lkolbly/ledgrid/fw/src/src/README.txt

Empty application. Add your own sources.
