lkolbly/ledgrid/(threads)

Thread 1 (2020-03-26):

3.3V and GND pogo pins swapped on programming board

lkolbly, 2020-03-26:
As the title says. Also, in general, the pogo board is non-trivial to align with the board - it should probably be moved close to an edge if possible.

Thread 2 (2020-10-07):

Issues to investigate/tackle for rev C

lkolbly, 2020-10-07:
* [ ] Bring all LPC programming pins to the edge of the board (touch pads are neat but tricky in practice)
* [ ] Replace variable resistors with fixed resistors (avoid accidentally setting resistance too low, difficulties in setting exact brightness control, component cost)
* [ ] Increase linear regulator size (current part can only do absolute max = 23mA @ 12V)
* [ ] Switch to 4 layer board, add ground plane
 * [ ] If so, move mounting holes to more convenient locations
* [ ] Add pads for I2C pullups
* [ ] Add emitter-base resistor on column driver's power transistors.
* [ ] Replace IC pads with elongated pads, if possible (for easy hand-soldering. Maybe move to back side?)

And do all of the above without changing the solder mask :D
