lkolbly/ledgrid/hw-v2/column_driver.cir

[Main]
FileType=CIR
Version=12.00
Program=Micro-Cap
Component Version=10.00
Shape Version=11.00
Screen=1920,1080
MCAPVersion=12.2.0.3
Key ID=Demo
NLCnt=73
TXCnt=0

[shapedef]
Name=Bjt.root
Line=0,0,13,0
Rectangle=13,-12,15,12
Current=32,-24,32,-16
Current=32,24,32,16
Current=0,-8,8,-8
PolyOpen=3
PolyLine=24,-24
PolyLine=24,-12
PolyLine=14,-2
PolyOpen=3
PolyLine=24,24
PolyLine=24,12
PolyLine=14,2

[shapedef]
Name=Diode
Root="Diode.root",0,0,0

[shapedef]
Name=Diode.root
Line=0,0,20,0
Line=28,0,48,0
Rectangle=18,-8,20,8
PolyClosed=3
PolyLine=20,0
PolyLine=28,-8
PolyLine=28,8
Current=32,16,16,16

[shapedef]
Name=Ground
Line=0,0,12,0
Line=12,-8,12,8
Line=18,-4,18,4
Line=24,0,24,0

[shapedef]
Name=Inv
Root="Inv.root",0,0,0

[shapedef]
Name=Inv.root
Line=8,-16,8,16
Line=8,-16,40,0
Line=8,16,40,0
Line=0,0,8,0
Ellipse=40,-2,44,2
FColor=None
Line=44,0,47,0
Line=46,0,48,0

[shapedef]
Name=Isource.Root
Ellipse=-12,12,12,36
FColor=None
Line=0,0,0,24
PolyClosed=3
PolyLine=-4,24
PolyLine=4,24
PolyLine=0,32
Line=0,32,0,48
Current=16,16,16,32

[shapedef]
Name=NPN
Root="Bjt.root",0,0,0
PolyClosed=3
PolyLine=20,12
PolyLine=24,12
PolyLine=24,8

[shapedef]
Name=Plus.root
Line=-2,0,2,0
Line=0,-2,0,2

[shapedef]
Name=PNP
Root="Bjt.root",0,0,0
PolyClosed=3
PolyLine=17,-5
PolyLine=21,-5
PolyLine=17,-9
Line=16,-4,14,-2
Line=16,4,14,2

[shapedef]
Name=Resistor
PolyOpen=12
PolyLine=0,0
PolyLine=0,0
PolyLine=12,0
PolyLine=14,-4
PolyLine=18,4
PolyLine=22,-4
PolyLine=26,4
PolyLine=30,-4
PolyLine=34,4
PolyLine=36,0
PolyLine=48,0
PolyLine=48,0
Current=32,8,16,8

[shapedef]
Name=SPICE_I
Root="Isource.Root",0,0,0

[shapedef]
Name=SPICE_V
Root="Vsource.root",0,0,0

[shapedef]
Name=StimClock
Arc=50,-8,62,8 , 56,8,62,0
Arc=50,-8,62,8 , 62,0,56,-8
Line=13,8,57,8
Arc=8,-8,18,8 , 13,-8,8,0
Ellipse=53,-3,59,3
Line=64,0,72,0
Arc=8,-8,18,8 , 8,0,13,8
Line=13,-8,57,-8
Line=56,0,64,0
Line=16,4,20,4
Line=20,4,20,-4
Line=20,-4,24,-4
Line=24,-4,24,4
Line=24,4,28,4
Line=28,4,28,-4
Line=28,-4,32,-4
Line=32,-4,32,4
Line=32,4,36,4
Line=36,4,36,-4
Line=36,-4,40,-4
Line=40,-4,40,4
Line=40,4,44,4
Line=44,4,44,-4
Line=44,-4,48,-4
Line=48,-4,48,4
Line=48,4,52,4

[shapedef]
Name=Vsource.root
Line=0,0,12,0
Line=36,0,48,0
Ellipse=12,-12,36,12
FColor=None
Line=7,5,7,9
Root="Plus.root",41,7,0
Current=32,16,16,16

[compdef]
Name=Resistor
Definition=Resistor
Shape=Resistor
Mask=6913
Used=154
memo=Resistor
Label Offset=18,6,8,11
PinCnt=2
Pin="Plus",6,0,-10,-4
Pin="Minus",0,0,-14,-4

[compdef]
Name=PNP
Definition=PNP
Shape=PNP
Mask=4609
Used=4
memo=PNP Transistor
Label Offset=37,-13,-8,35
PinCnt=3
Pin="Collector",3,3,6,3
Pin="Base",0,0,-19,-3
Pin="Emitter",3,-3,6,15

[compdef]
Name=NPN
Definition=NPN
Shape=NPN
Mask=5633
Used=15
memo=NPN Transistor
Label Offset=37,-17,-14,33
PinCnt=3
Pin="Collector",3,-3,4,14
Pin="Base",0,0,-18,-3
Pin="Emitter",3,3,5,1

[compdef]
Name=Ground
Definition=Ground
Shape=Ground
Mask=1793
Used=261
memo=Ground
Label Offset=0,0,0,0
PinCnt=1
Pin="PinA",0,0,-3,-7

[compdef]
Name=Voltage Source
Definition=VSpice
Shape=SPICE_V
Mask=5377
Used=41
memo=Voltage Source
Label Offset=19,13,15,13
PinCnt=2
Pin="Plus",6,0,-5,-6
Pin="Minus",0,0,-20,-6

[compdef]
Name=DClock
Definition=Macro
Shape=StimClock
Mask=5376
Used=3
memo=Digital Clock Stimulus Macro
Link=http://www.spectrum-soft.com/news/fall2003/dclock.shtm
Label Offset=29,10,12,21
PinCnt=1
Pin="Out",d,9,0

[compdef]
Name=D-LED
Definition=Subckt
Shape=Diode
Mask=6272
Used=6
memo=On Semi
Label Offset=0,0,0,0
PinCnt=2
Pin="1",a,6,0,1,0
Pin="2",a,0,0

[compdef]
Name=Current Source
Definition=ISpice
Shape=SPICE_I
Mask=6401
Used=7
memo=Current Source
Label Offset=15,12,-29,12
PinCnt=2
Pin="Plus",0,0,8,11
Pin="Minus",0,6,8,3

[compdef]
Name=Inverter
Definition=INV
Shape=Inv
Mask=4611
Used=1
Data1=1
memo=Generic Inverter Gate
Label Offset=12,-6,11,21
PinCnt=2
Pin="In",0,0,-4,-2
Pin="Out",6,0,-10,-2

[Circuit]
Window Placement=2,3, -1,-1, -8,-31, 104,104,1559,680
Default Object=Color=#000080
Default Object Font=Height=-15,FStyle=0,Color=#000080,Name=Arial
Default Object Apply Border To Text=No
Default Object Apply Fill To Text=No
Default Object GridSnap=No
NodeVoltageFormat=3
CurrentFormat=3
PowerFormat=3
PathDelayFormat=3
WarningFormat=3
GridTextFormulaFormat=3
Window Placement in Transient Analysis=2,3, -1,-1, -8,-31, 260,260,1911,836
Window Placement in DC Analysis=2,3, -1,-1, -8,-31, 130,130,1781,706
Window Placement in DC Probe=0,1, -1,-1, -8,-31, 953,0,1906,832
SpiceType=AMBIGUOUS
Title_Block_Border=None
Title_Block=False
Show Nodes=False
Show Voltages=False
Show Current=False
Show Power=False
Show Condition=False
Show Pin Connections=False
Show Connection Warnings=False
Show Cross=False
Show Attribute Text=True
Show Grid Text=True

[Comp]
Name=Resistor
Px=632,392
Rot=3

[Attr]
ON=-24,-25,PART
V=R1
Style=8192

[Attr]
ON=-24,-39,RESISTANCE
V=1K
Style=8192

[Attr]
ON=0,0,PACKAGE
V

[Comp]
Name=Resistor
Px=696,488
Rot=3

[Attr]
ON=-24,-25,PART
V=R2
Style=8192

[Attr]
ON=-24,-39,RESISTANCE
V=1K
Style=8192

[Attr]
ON=0,0,PACKAGE
V

[Comp]
Name=PNP
Px=632,312
Rot=5

[Attr]
ON=-10,-43,PART
V=Q1
Style=8192

[Attr]
ON=-104,-15,MODEL
V=MMST3906

[Attr]
ON=-75,-43,PACKAGE
V=SC-59

[Comp]
Name=NPN
Px=696,440
Rot=3

[Attr]
ON=-7,-43,PART
V=Q2
Style=8192

[Attr]
ON=-86,-3,MODEL
V=BC850B

[Attr]
ON=-82,25,PACKAGE
V=SOT-23

[Comp]
Name=Ground
Px=720,416
Rot=7

[Wire]
Pxs=632,392,632,416

[Wire]
Pxs=632,416,672,416

[Wire]
Pxs=632,312,632,344

[Comp]
Name=Voltage Source
Px=728,360
Rot=5

[Attr]
ON=15,-27,PART
V=V1
Style=8192

[Attr]
ON=15,-41,VALUE
V=DC 12 AC 0 0 

[Attr]
ON=0,0,PACKAGE
V

[Attr]
ON=0,0,SMOOTHING
V=N
Style=256

[Attr]
ON=0,0,Saved_PulseS
V=N
Style=256

[Attr]
ON=0,0,FRACTION
V=.2
Style=256

[Attr]
ON=0,0,Saved_PulseF
V=.2
Style=256

[Attr]
ON=0,0,Saved_Pulse
V=DC 0 AC 1 0 Pulse 0 5 100n 10n 10n 400n 1u
Style=256

[Attr]
ON=0,0,Saved_None
V=DC 12 AC 0 0 
Style=256

[Wire]
Pxs=728,360,728,416

[Wire]
Pxs=720,416,728,416

[Wire]
Pxs=728,288,728,312

[Wire]
Pxs=656,288,728,288

[Comp]
Name=DClock
Px=816,624
Rot=5

[Attr]
ON=12,-35,PART
V=X1
Style=8192

[Attr]
ON=12,-49,FILE
V=DClock

[Attr]
ON=12,-77,Param:ZEROWIDTH
V=4us

[Attr]
ON=12,-91,Param:ONEWIDTH
V=4us

[Attr]
ON=0,0,PACKAGE
V

[Comp]
Name=D-LED
Px=472,224

[Attr]
ON=0,0,PART
V=X2
Style=8192

[Attr]
ON=0,14,NAME
V=D-LED
Style=8192

[Attr]
ON=0,0,PACKAGE
V

[Comp]
Name=D-LED
Px=472,280

[Attr]
ON=0,0,PART
V=X3
Style=8192

[Attr]
ON=0,14,NAME
V=D-LED
Style=8192

[Attr]
ON=0,0,PACKAGE
V

[Comp]
Name=D-LED
Px=472,336

[Attr]
ON=0,0,PART
V=X4
Style=8192

[Attr]
ON=0,14,NAME
V=D-LED
Style=8192

[Attr]
ON=0,0,PACKAGE
V

[Wire]
Pxs=520,224,568,224

[Wire]
Pxs=568,224,568,280

[Wire]
Pxs=520,336,568,336

[Wire]
Pxs=520,280,568,280

[Wire]
Pxs=568,280,568,288

[Wire]
Pxs=568,288,608,288

[Wire]
Pxs=568,288,568,336

[Comp]
Name=Current Source
Px=416,224
Rot=1

[Attr]
ON=-29,12,PART
V=I1
Style=8192

[Attr]
ON=-29,26,VALUE
V=DC 0.03 AC 0 0 
Style=8192

[Attr]
ON=0,0,PACKAGE
V

[Attr]
ON=0,0,SMOOTHING
V=N
Style=256

[Attr]
ON=0,0,Saved_PulseS
V=N
Style=256

[Attr]
ON=0,0,FRACTION
V=.2
Style=256

[Attr]
ON=0,0,Saved_PulseF
V=.2
Style=256

[Attr]
ON=0,0,Saved_Pulse
V=DC 0 AC 1 0 Pulse 0 5 100n 10n 10n 400n 1u
Style=256

[Attr]
ON=0,0,Saved_None
V=DC 0.03 AC 0 0 
Style=256

[Comp]
Name=Current Source
Px=416,280
Rot=1

[Attr]
ON=-29,12,PART
V=I2
Style=8192

[Attr]
ON=-29,26,VALUE
V=DC 0.03 AC 0 0 
Style=8192

[Attr]
ON=0,0,PACKAGE
V

[Attr]
ON=0,0,Saved_None
V=DC 0.03 AC 0 0 
Style=256

[Comp]
Name=Current Source
Px=416,336
Rot=1

[Attr]
ON=-29,12,PART
V=I3
Style=8192

[Attr]
ON=-29,26,VALUE
V=DC 0.03 AC 0 0
Style=8192

[Attr]
ON=0,0,PACKAGE
V

[Comp]
Name=Ground
Px=344,376
Rot=7

[Wire]
Pxs=344,224,368,224

[Wire]
Pxs=344,224,344,280

[Wire]
Pxs=344,280,368,280

[Wire]
Pxs=344,280,344,336

[Wire]
Pxs=344,336,368,336

[Wire]
Pxs=344,336,344,376

[Comp]
Name=Resistor
Px=864,336
Rot=3

[Attr]
ON=-24,-25,PART
V=R3
Style=8192

[Attr]
ON=-24,-39,RESISTANCE
V=1K
Style=8192

[Attr]
ON=0,0,PACKAGE
V

[Comp]
Name=Resistor
Px=928,432
Rot=3

[Attr]
ON=-24,-25,PART
V=R4
Style=8192

[Attr]
ON=-24,-39,RESISTANCE
V=1K
Style=8192

[Attr]
ON=0,0,PACKAGE
V

[Comp]
Name=PNP
Px=864,256
Rot=5

[Attr]
ON=-10,-43,PART
V=Q3
Style=8192

[Attr]
ON=-104,-15,MODEL
V=MMST3906

[Attr]
ON=-75,-43,PACKAGE
V=SC-59

[Comp]
Name=NPN
Px=928,384
Rot=3

[Attr]
ON=-7,-43,PART
V=Q4
Style=8192

[Attr]
ON=-86,-3,MODEL
V=BC850B

[Attr]
ON=-82,25,PACKAGE
V=SOT-23

[Comp]
Name=Ground
Px=952,360
Rot=7

[Wire]
Pxs=864,336,864,360

[Wire]
Pxs=864,360,904,360

[Wire]
Pxs=864,256,864,288

[Comp]
Name=Voltage Source
Px=960,304
Rot=5

[Attr]
ON=15,-27,PART
V=V2
Style=8192

[Attr]
ON=15,-41,VALUE
V=DC 12 AC 0 0 

[Attr]
ON=0,0,PACKAGE
V

[Attr]
ON=0,0,SMOOTHING
V=N
Style=256

[Attr]
ON=0,0,Saved_PulseS
V=N
Style=256

[Attr]
ON=0,0,FRACTION
V=.2
Style=256

[Attr]
ON=0,0,Saved_PulseF
V=.2
Style=256

[Attr]
ON=0,0,Saved_Pulse
V=DC 0 AC 1 0 Pulse 0 5 100n 10n 10n 400n 1u
Style=256

[Attr]
ON=0,0,Saved_None
V=DC 12 AC 0 0 
Style=256

[Wire]
Pxs=960,304,960,360

[Wire]
Pxs=952,360,960,360

[Wire]
Pxs=960,232,960,256

[Wire]
Pxs=888,232,960,232

[Comp]
Name=Inverter
Px=816,552
Rot=5

[Attr]
ON=-29,-8,PART
V=U1
Style=8192

[Attr]
ON=-68,-22,TIMING MODEL
V=D0_GATE

[Attr]
ON=-59,-36,I/O MODEL
V=IO_STD

[Attr]
ON=-20,-50,MNTYMXDLY
V=0

[Attr]
ON=-20,-64,IO_LEVEL
V=0

[Attr]
ON=-76,-78,POWER NODE
V=$G_DPWR

[Attr]
ON=-73,-92,GROUND NODE
V=$G_DGND

[Attr]
ON=0,0,PACKAGE
V

[Wire]
Pxs=696,504,816,504

[Wire]
Pxs=696,488,696,504

[Wire]
Pxs=816,552,928,552

[Wire]
Pxs=928,432,928,552

[Comp]
Name=D-LED
Px=472,48

[Attr]
ON=0,0,PART
V=X5
Style=8192

[Attr]
ON=0,14,NAME
V=D-LED
Style=8192

[Attr]
ON=0,0,PACKAGE
V

[Comp]
Name=D-LED
Px=472,104

[Attr]
ON=0,0,PART
V=X6
Style=8192

[Attr]
ON=0,14,NAME
V=D-LED
Style=8192

[Attr]
ON=0,0,PACKAGE
V

[Comp]
Name=D-LED
Px=472,160

[Attr]
ON=0,0,PART
V=X7
Style=8192

[Attr]
ON=0,14,NAME
V=D-LED
Style=8192

[Attr]
ON=0,0,PACKAGE
V

[Wire]
Pxs=520,48,568,48

[Wire]
Pxs=520,160,568,160

[Wire]
Pxs=520,104,568,104

[Wire]
Pxs=416,48,472,48

[Wire]
Pxs=416,48,416,224

[Wire]
Pxs=432,104,472,104

[Wire]
Pxs=432,104,432,280

[Wire]
Pxs=448,160,472,160

[Wire]
Pxs=448,160,448,336

[Wire]
Pxs=416,336,448,336

[Wire]
Pxs=448,336,472,336

[Wire]
Pxs=416,280,432,280

[Wire]
Pxs=432,280,472,280

[Wire]
Pxs=416,224,472,224

[Wire]
Pxs=568,48,568,104

[Wire]
Pxs=568,104,568,160

[Wire]
Pxs=568,104,840,104

[Wire]
Pxs=840,104,840,232

[Schematic]
CurrentSection 0=0
CurrentSection 1=0
CurrentSection 2=0
CurrentSection 3=0
Splitter.xs=0
Splitter.ys=0
TextQuad=4099
Scale=1
GridUser=10
ShapeGroups="Main","Euro","Polarity","Main1","Main11","Electrolytic","GroundArrow","DeMorgan"
CalcRMS=False
CalcAVG=False
CalcPeak=False
CalcVoltage=True
DisplayMeasure=Last
ShareScales=True

[Tools]
Pos=Top
FILESAVEASOLD=No
BOM=No
FILEPCB=No
PROBE=Yes
SELECT=Yes
PAN=Yes
COMP=Yes
TEXT=Yes
WIRE=Yes
WIRED=Yes
BUS=Yes
GRAPHIC=Yes
FLOWCHART=Yes
LINE=No
ELLIPSE=No
RECT=No
DIAM=No
ARC=No
PIE=No
TRIANGLE=No
STAR=No
LEFTBRK=No
RIGHTBRK=No
BOTHBRK=No
META=Yes
PARALLELOGRAM=No
FC_PROCESS=No
FC_ALT_PROCESS=No
FC_DECISION=No
FC_DATA=No
FC_PREDEFPROCESS=No
FC_INTERNALSTORAGE=No
FC_DOCUMENT=No
FC_MULTIDOCUMENT=No
FC_TERMINATOR=No
FC_PREPARATION=No
FC_MANUALINPUT=No
FC_MANUALOPERATION=No
FC_CONNECTOR=No
FC_OFFPAGECONNECTOR=No
FC_PUNCHCARD=No
FC_PUNCHEDTAPE=No
FC_SUMMING_JUNCTION=No
FC_OR=No
FC_COLLATE=No
FC_SORT=No
FC_EXTRACT=No
FC_MERGE=No
FC_STORED_DATA=No
FC_DELAY=No
FC_SAS=No
FC_MAGNETIC_DISK=No
FC_DAS=No
FC_DISPLAY=No
SPREAD_SHEET=Yes
POLYCLOS=No
POLYOPEN=No
FLAG=Yes
INFO=Yes
HELP=Yes
HELP_SPICE=No
LINK=Yes
CHECK=Yes
REGION_ENABLE=Yes
TITLE_BLOCK=Yes
DIGTRC=No
DIGTRC2=No
BUILD_COMMAND=Yes
DIGALL=No
GRIDTEXT=Yes
COMPTEXT=Yes
NODE=Yes
MEASURED=Yes
NODEV=Yes
CURRENT=Yes
POWER=Yes
CONDITIN=Yes
PIN=Yes
CONNWARN=Yes
CROSS=Yes
GRID=Yes
BORDER=Yes
BORDERONE=Yes
TITLE=Yes
RUBBER=Yes
PROPERTY=Yes
STEP=Yes
MIRROR=Yes
ROTATE=Yes
FLIPY=Yes
FLIPX=Yes
CIR_MAKEMACRO=No
CLEARCUTWIRE=No
CLIPBOARDCIRPAGE2BMM=No
FINDCOMP=Yes
FIND=Yes
REPEAT=No
REPLACE=No
MODEL=Yes
CIR2CKT=Yes
ATTDISP=Yes
ENABLE=Yes
DISABLE=Yes
ENABLE_WITH=Yes
TOFRONT=Yes
TOBACK=Yes
SELNEXT=Yes
PAGEADD=Yes
PAGEADDTEXT=No
ADDSECTION=No
PAGEDEL=Yes
ZOOMIN=Yes
ZOOMOUT=Yes
AUTOSCALECIR=Yes
GOTOFLAG=Yes
UPLEVEL=Yes
COLOR=Yes
FONT=Yes
STYLE=Yes
DM_LAST=No
DM_RMS=No
DM_AVG=No
DM_PEAK=No
GRID_NONE=No
GRID_NORMAL=No
GRID_BOLD_5=No
GRID_BOLD_6=No
GRID_BOLD_USER=No
GRAPH_PAPER=No
SPLITCIRTEXTH=No
SPLITCIRTEXTV=No
SPACE_SPLITTERS_EVENLY=No
NORMALCIR=No
RENAMEDEFINE=No
RENAMECMP=No
ATTALIGN=No
RESETNODEPOS=No
FIT2STANDARD=No
NODESNAP=No
MOVETEXT=No
TEXTINC=No
TOGGLETEXT=No
TOGGLEMODE=No
TOLERANCE=No
ALIGNAB=No
ALIGNLEFT=Yes
ALIGNCENTER=Yes
ALIGNRIGHT=Yes
ALIGNTOP=Yes
ALIGNMIDDLES=Yes
ALIGNBOTTOM=Yes

[Section]
Index=0
Name="column_driver"
Type=Main
Enable=True
CurrentPage 0=0
CurrentPage 1=0
CurrentPage 2=0
CurrentPage 3=0
TabSize 0=425
TabSize 1=425
TabSize 2=425
TabSize 3=425

[Page]
Index=0
Section=0
Print=True
Enable=True
Name=Main
PrinterScale=1
Scale 0=1
Scale 1=1
Scale 2=1
Scale 3=1
Px=814,586
WinBackGround Color=#FFFFFF
Select Color=#FF0000
Anchor Color=#000000
Select Box Color=#000080
Grid Text Color=Height=-12,FStyle=0,Color=#0000FF,Name=Verdana
Grid Text RTF=False
Grid Text Angle=0
Grid Text GridSnap=True
Grid Text PinIt=False
Grid Text JustifyH=Left
Grid Text JustifyV=Bottom
Grid GradientColor2=None
Grid OutlineThickness=1
Grid OutlineColor=None
Component Color=#0000FF
Attribute Text=Height=-12,FStyle=0,Color=#008000,Name=Verdana
Wire Color=#008000
Bus Color=#008000
Pin Connection=Height=-10,FStyle=0,Color=#FF0000,Name=Arial
Pin Marker Color=#008000
Node Number=Height=-11,FStyle=0,Color=#FF00FF,Name=Arial
Node Voltage Color=Height=-11,FStyle=0,Color=#000000,Name=Arial
Dynamic AC Voltage Color=#E4E4E4
Text Banner Text=Height=-15,FStyle=0,Color=#800000,Name=Arial
Title Block Background=#C0C0C0
Current=Height=-11,FStyle=0,Color=#0000FF,Name=Arial
Power/Condition=Height=-11,FStyle=0,Color=#FF0000,Name=Arial
Digital Path Color=#FF0000
Title Block Border=#000000
Disabled	Color=#C0C0C0
Search Color=#FFFF00
Grid Color=#000000
Graph Paper=#E4E4E4
Digital 0 Color=#000000
Digital R Color=#FFFF00
Digital F Color=#FFFF00
Digital 1 Color=#FF0000
Digital X Color=#C0C0C0
Digital Z Color=#808080
Block Select Color=#51F998

[Page]
Index=1
Section=0
Type=Text
Print=False
Enable=True
Name=Text
Font=Height=-15,FStyle=0,Color=#000000,Name=Courier New
Comment Color=#008000
WinBackGround Color=#FFFFFF
Disabled	Color=#C0C0C0
KeyWord Color=#0000FF
Error	Color=#FF0000
Search Color=#FFFF00

[Page]
Index=2
Section=0
Type=Text
Print=False
Enable=True
Name=Models
SB 0=0,31
Font=Height=-15,FStyle=0,Color=#000000,Name=Courier New
Comment Color=#008000
WinBackGround Color=#FFFFFF
Disabled	Color=#C0C0C0
KeyWord Color=#0000FF
Error	Color=#FF0000
Search Color=#FFFF00

[Page]
Index=3
Section=0
Type=Info
Print=False
Enable=True
Name=Info
Font=Height=-15,FStyle=0,Color=#000000,Name=Courier New
Comment Color=#008000
WinBackGround Color=#FFFFFF
Disabled	Color=#C0C0C0
KeyWord Color=#0000FF
Error	Color=#FF0000
Search Color=#FFFF00

[Text Area]
Section=0
Page=1
Text=.OPTIONS ITL4=50

[Text Area]
Section=0
Page=2
Text=* Schematic File
Text=*
Text=* Syntax:
Text=* .MODEL <model name> [AKO:<reference model name>] <ModelType>
Text=* +([<parameter name>=<value>][LOT[/#][/GAUSS|/UNIFORM|/WCASE]=[<tol>[%]] |[-<low>%,<high>%]][DEV[/#][/GAUSS|/UNIFORM|/WCASE]=[<tol>[%]]...)
Text=* ModelType must be one of OPA,D,NPN,NMOS,NJF,PUL,SIN,TRN,CORE,GASFET,VSWITCH,ISWITCH,CAP,IND,RES,PNP,PMOS,PJF,DOUTPUT,DINPUT,UADC,UDAC,UGATE,UTGATE,UEFF,UGFF,UDLY,UPLD,UROM,URAM,UBGT,UIO,LPNP,NIGBT,I,V
Text=*
Text=*Examples:
Text=* .MODEL 2N2222A NPN(BF=150 IS=1E-14)
Text=* .model M1 NMOS(KP=2.5E-5 VTO=1.345 CGDO=14.67p CGBO=4.566p)
Text=* .MODEL DK D(IS=1E-18)
Text=* .model 2N2222A AKO:2N2222 NPN (BF=55 ISE=10F)
Text=* .Model BJT1 NPN (RE=12 LOT/1/GAUSS=30% DEV/2/UNIFORM=2%)
Text=*
Text=* A .cir file is typically found in the data directory
Text=*
Text=*** From file C:\MC12\library\DIODESINC_BJT.LIB
Text=.MODEL MMSTA55 PNP (BF=331 BR=4.00 CJC=40.2P CJE=125P EG=1.12 IKF=0.182
Text=+ IKR=0.450 IS=50.2F ISE=20.3P MJC=0.300 MJE=0.500 NE=2.00 NF=1.00 NR=1.00
Text=+ RB=0.532 RC=53.2M RE=0.133 TF=2.16N TR=350N VAF=139 VAR=16.0 VJC=0.300
Text=+ VJE=1.10 XTB=1.5)
Text=*** From file C:\MC12\library\ROHM_TRANSISTOR.LIB
Text=.MODEL MMSTA56 PNP (BF=235.45 BR=6.9168 CJC=36.541E-12 CJE=132.70E-12
Text=+ IKF=1.6011 IKR=.94462 IS=300.00E-15 ISC=6.2373E-12 ISE=300.00E-15 ITF=29.965
Text=+ MJC=.44608 MJE=.4689 NC=1.4308 NE=1.5074 NK=.82728 RB=.91923 RC=.13026 RE=.15
Text=+ TF=681.79E-12 TR=144.75E-9 VAF=39.033 VAR=100 VJC=.74006 VJE=.99813
Text=+ VTF=119.68 XTB=1.5000 XTF=78.625)
Text=*** From file C:\MC12\library\DIODESINC_BJT.LIB
Text=.MODEL MMSTA92 PNP (BF=164 BR=4.00 CJC=16.8P CJE=52.0P EG=1.12 IKF=66.8M
Text=+ IKR=0.165 IS=53.7F ISE=25.7P MJC=0.300 MJE=0.500 NE=2.00 NF=1.00 NR=1.00
Text=+ RB=2.26 RC=0.226 RE=0.565 TF=2.46N TR=426N VAF=312 VAR=20.0 VJC=0.300
Text=+ VJE=1.10 XTB=1.5)

[InfoPage]
InfoPage=True
Warnings=True
System=True
Defines=True
Array=True
Model=True
Measure=True
MacroSubckt=True
NotUsed=True
ComponentCounts=True
VariablizePaths=False
DontShowPaths=False
SimulationLog=True

[Transient]
WinID=1
Window Placement=2,3, -1,-1, -8,-31, 260,260,1911,836
Font=Height=-19,FStyle=0,Color=#0000FF,Name=Arial
WinBackGround Color=#FFFFFF
Select Color=#FF0000
Anchor Color=#000000
Select Box Color=#000080
Title=column_driver.cir
AutoTitle=Yes
Grid Color=#808080
Grid Weight=1
Grid Pattern=Dot6
Tracker Foreground=Height=-15,FStyle=0,Color=#000000,Name=Arial
Tracker Background=#FFFF00
Baseline color=#0000FF
BaseLine Weight=1
CurveFit color=#FF0000
CurveFit Weight=2
CurveFit Pattern=Dash
Static Grids=False
PlusMark=False
MinorLog25=Off
LabelMinor=Off
DataPoints=False
Token=False
Ruler=False
XAxisGrids=True
YAxisGrids=True
MinorLogGrids=True
BaseLine=False
AlignZ=True
Align Cursors=True
TagFormatX=3
TagFormatY=3
FormulaFormat=2
EndMode=SCALE
Graph Background=#FFFFFF
Tracker Intercept=False
Tracker Mouse=True
Tracker Cursor=True
Tracker Cursor BranchInfo=False
Horizontal Cursor=False
Same Y Scales=Yes
Enable X Scaling=True
Enable Y Scaling=True
Keep X Scales The Same=True
Number of Grids X=5
Number of Grids Y=5
Cursor Select Color Primary=#C0C0C0
Cursor Select Color Secondary=#FF0000
Data Point Labels Color Fore=Height=-15,FStyle=0,Color=#000000,Name=Arial
Data Point Labels Color Back=#FFFF00
OperPoint=True
OperPointOnly=False
AutoScaleRanges=True
FixedTimeStep=False
DoPSS=False
PSS_Periods="1"
PSS_Iterations="5"
PSS_Error="1u"
PSS_ShowPlots=True
FFT_NPts="8192"
FFT_IncludeDCHarmonic=False
FFT_AutoScale_Harmonics="10"
PrinterAutoTile=No
PrinterBlackBorder=No
MonMaxShow=4
MonPageWidth=66
MonPlotWidth=21
MonExprXWidth=142
MonExprYWidth=367
MonRangeXWidth=90
MonRangeYWidth=90
AnimateWait=None
AnimateWaitTime=500
AnimatePressAfter=0
Save_For_Future=No
Reduce_Display=1
Reduce_Save=1
Reduce_ThrowDataOut=0
Num Out Header Left
Num Out Header Center="$MC\n$user\n$company\n$Analysis of $name\n$date $time"
Num Out Header Right
Num Out Delimiter=32
Num Out Write=True
Num Out Write Main Header=True
Num Out Write Limits=True
Num Out Write Branch Header=True
Num Out Write Models=False
Num Out Write Zero Models=True
Num Out Write Undefined Models=True
Num Out Write Operating Point=True
Num Out Write Measurement Values=True
Num Out Write Tolerance Detail=True
Num Out Write Values=True
Num Out Write Waveform Header=True
Num Out Allow Dup Y Expr=False
Num Out Low="TSTART"
Num Out High="TMAX"
Num Out Font=Height=-15,FStyle=0,Color=#000000,Name=Courier New
Num Out Format=3
Num Out HideNonSelected=False
Num Out UseActualDataPoints=False
AutoSaveWave=False
Wave Format=16E
State Variables Format=5E
Print Individual Pages=False

[Tools]
Pos=Top
SELECT=Yes
PAN=Yes
GRAPHIC=Yes
LINE=No
ELLIPSE=No
RECT=No
DIAM=No
ARC=No
PIE=No
TRIANGLE=No
STAR=No
LEFTBRK=No
RIGHTBRK=No
BOTHBRK=No
META=Yes
PARALLELOGRAM=No
POLYCLOS=No
POLYOPEN=No
SCALE=Yes
CURSOR=Yes
MEASUREH=Yes
MEASUREV=Yes
TAG=Yes
PTAG=Yes
TEXT=Yes
PROPERTY=Yes
START=Yes
STOP=Yes
PAUSE=Yes
RESUME=No
DATAPTS=Yes
TOKENS=Yes
RULER=Yes
PLUS=Yes
XAXIS=Yes
YAXIS=Yes
MINORLOG=Yes
LOG25=Yes
BASELINE=Yes
HORIZCUR=Yes
GOTOX=Yes
GOTOY=Yes
GOTOPERF=Yes
GOTOBRNC=Yes
CLEAR_ACCUMULATED=Yes
PDELETE_ALL_PLOTS=Yes
NEXT=Yes
NEXTIN=Yes
PEAK=Yes
VALLEY=Yes
HIGH=Yes
LOW=Yes
INFLECTN=Yes
GHIGH=Yes
GLOW=Yes
BOTTOM=Yes
TOP=Yes
WAVEFORMBUFFER=Yes
AOUTPUT=Yes
PKEY=Yes
ENXSCALE=Yes
ENYSCALE=Yes
ZOOMIN=Yes
ZOOMOUT=Yes
AUTOSCALE=Yes
RESTORESCALE=No
COLOR=Yes
FONT=Yes
STYLE=Yes
SELNEXT=Yes
NORMALIZE=No
NORMALIZE_MIN=No
NORMALIZE_MAX=No
ADD_TAG_LEFT=No
ADD_TAG_RIGHT=No
ADD_HORZ_TAG=No
ADD_VERT_TAG=No
ALIGN_CURSORS=No
ALIGN_CURSORSZ=No
CURSORTOCLIPBOARD=No
TRACKER_CURSOR=No
TRACKER_CURSOR_BRANCHINFO=No
TRACKER_INTERCEPT=No
TRACKER_MOUSE=No
TOFRONT=Yes
TOBACK=Yes
SPLITCIRTEXTH=No
SPLITCIRTEXTV=No
SPACE_SPLITTERS_EVENLY=No
NORMALCIR=No
LABEL_WAVEFORM=No
LABEL_DATA_POINTS=No
WFB_ADD_TO_LIMITS=No
ENVELOPE=No
SAMEYSCALES=No
KEEPXSCALESTHESAME=No
CURVEFIT=No
ADD_MARKER=No
SHOWWATCH=No
BP=No
TOGGLEMODE=No
REMOVEALLTEXT=No
AUTOSCALEX=No
LABELALLMINOR=No
ALIGNLEFT=Yes
ALIGNCENTER=Yes
ALIGNRIGHT=Yes
ALIGNTOP=Yes
ALIGNMIDDLES=Yes
ALIGNBOTTOM=Yes

[APage]
Analysis=Transient
Name="MAIN"

[DC]
WinID=3
Window Placement=2,3, -1,-1, -8,-31, 130,130,1781,706
Font=Height=-19,FStyle=0,Color=#0000FF,Name=Arial
WinBackGround Color=#FFFFFF
Select Color=#FF0000
Anchor Color=#000000
Select Box Color=#000080
Window Placement in Probe=0,1, -1,-1, 0,0, 0,0,953,832
Title
AutoTitle=Yes
Grid Color=#808080
Grid Weight=1
Grid Pattern=Dot6
Tracker Foreground=Height=-15,FStyle=0,Color=#000000,Name=Arial
Tracker Background=#FFFF00
Baseline color=#0000FF
BaseLine Weight=1
CurveFit color=#FF0000
CurveFit Weight=2
CurveFit Pattern=Dash
Static Grids=False
PlusMark=False
MinorLog25=Off
LabelMinor=Off
DataPoints=False
Token=False
Ruler=False
XAxisGrids=True
YAxisGrids=True
MinorLogGrids=True
BaseLine=False
AlignZ=True
Align Cursors=True
TagFormatX=3
TagFormatY=3
FormulaFormat=2
EndMode=SCALE
Graph Background=#FFFFFF
Tracker Intercept=False
Tracker Mouse=True
Tracker Cursor=True
Tracker Cursor BranchInfo=False
Horizontal Cursor=False
Same Y Scales=Yes
Enable X Scaling=True
Enable Y Scaling=True
Keep X Scales The Same=True
Number of Grids X=5
Number of Grids Y=5
Cursor Select Color Primary=#C0C0C0
Cursor Select Color Secondary=#FF0000
Data Point Labels Color Fore=Height=-15,FStyle=0,Color=#000000,Name=Arial
Data Point Labels Color Back=#FFFF00
AutoScaleRanges=True
PrinterAutoTile=No
PrinterBlackBorder=No
MonMaxShow=3
MonPageWidth=66
MonPlotWidth=21
MonExprXWidth=142
MonExprYWidth=286
MonRangeXWidth=90
MonRangeYWidth=90
AnimateWait=None
AnimateWaitTime=500
AnimatePressAfter=0
Save_For_Future=No
Reduce_Display=1
Reduce_Save=1
Reduce_ThrowDataOut=0
Num Out Header Left
Num Out Header Center="$MC\n$user\n$company\n$Analysis of $name\n$date $time"
Num Out Header Right
Num Out Delimiter=32
Num Out Write=True
Num Out Write Main Header=True
Num Out Write Limits=True
Num Out Write Branch Header=True
Num Out Write Models=False
Num Out Write Zero Models=True
Num Out Write Undefined Models=True
Num Out Write Measurement Values=True
Num Out Write Tolerance Detail=True
Num Out Write Values=True
Num Out Write Waveform Header=True
Num Out Allow Dup Y Expr=False
Num Out Low="DCMIN"
Num Out High="DCMAX"
Num Out Font=Height=-15,FStyle=0,Color=#000000,Name=Courier New
Num Out Format=3
Num Out HideNonSelected=False
Num Out UseActualDataPoints=False
AutoSaveWave=False
Wave Format=16E
State Variables Format=5E
Print Individual Pages=False

[Tools]
Pos=Top
SELECT=Yes
PAN=Yes
GRAPHIC=Yes
LINE=No
ELLIPSE=No
RECT=No
DIAM=No
ARC=No
PIE=No
TRIANGLE=No
STAR=No
LEFTBRK=No
RIGHTBRK=No
BOTHBRK=No
META=Yes
PARALLELOGRAM=No
POLYCLOS=No
POLYOPEN=No
SCALE=Yes
CURSOR=Yes
MEASUREH=Yes
MEASUREV=Yes
TAG=Yes
PTAG=Yes
TEXT=Yes
PROPERTY=Yes
START=Yes
STOP=Yes
PAUSE=Yes
RESUME=No
DATAPTS=Yes
TOKENS=Yes
RULER=Yes
PLUS=Yes
XAXIS=Yes
YAXIS=Yes
MINORLOG=Yes
LOG25=Yes
BASELINE=Yes
HORIZCUR=Yes
GOTOX=Yes
GOTOY=Yes
GOTOPERF=Yes
GOTOBRNC=Yes
CLEAR_ACCUMULATED=Yes
PDELETE_ALL_PLOTS=Yes
NEXT=Yes
NEXTIN=Yes
PEAK=Yes
VALLEY=Yes
HIGH=Yes
LOW=Yes
INFLECTN=Yes
GHIGH=Yes
GLOW=Yes
BOTTOM=Yes
TOP=Yes
WAVEFORMBUFFER=Yes
AOUTPUT=Yes
PKEY=Yes
ENXSCALE=Yes
ENYSCALE=Yes
ZOOMIN=Yes
ZOOMOUT=Yes
AUTOSCALE=Yes
RESTORESCALE=No
COLOR=Yes
FONT=Yes
STYLE=Yes
SELNEXT=Yes
NORMALIZE=No
NORMALIZE_MIN=No
NORMALIZE_MAX=No
ADD_TAG_LEFT=No
ADD_TAG_RIGHT=No
ADD_HORZ_TAG=No
ADD_VERT_TAG=No
ALIGN_CURSORS=No
ALIGN_CURSORSZ=No
CURSORTOCLIPBOARD=No
TRACKER_CURSOR=No
TRACKER_CURSOR_BRANCHINFO=No
TRACKER_INTERCEPT=No
TRACKER_MOUSE=No
TOFRONT=Yes
TOBACK=Yes
SPLITCIRTEXTH=No
SPLITCIRTEXTV=No
SPACE_SPLITTERS_EVENLY=No
NORMALCIR=No
LABEL_WAVEFORM=No
LABEL_DATA_POINTS=No
WFB_ADD_TO_LIMITS=No
ENVELOPE=No
SAMEYSCALES=No
KEEPXSCALESTHESAME=No
CURVEFIT=No
ADD_MARKER=No
SHOWWATCH=No
BP=No
TOGGLEMODE=No
REMOVEALLTEXT=No
AUTOSCALEX=No
LABELALLMINOR=No
ALIGNLEFT=Yes
ALIGNCENTER=Yes
ALIGNRIGHT=Yes
ALIGNTOP=Yes
ALIGNMIDDLES=Yes
ALIGNBOTTOM=Yes

[APage]
Analysis=DC
Name="Main"

[Monte Carlo Options]
Analysis=Transient
Status=Off
Zero Tolerance=False
Eliminate Outliers=False
Distribution=Normal
Number of Runs=10
Seed=0

[Monte Carlo Options]
Analysis=DC
Status=Off
Zero Tolerance=False
Eliminate Outliers=False
Distribution=Normal
Number of Runs=10
Seed=0

[Limits]
Analysis=Transient
TMax=10u
TStart=0
TStep=0
NPts=51
Temp=27
RetraceRuns=1
StateVar=Zero
RunOption=Normal
Temperature Type=Linear
Accumulate Plots=False
IgnoreExprErrors=False

[WaveForm]
Analysis=Transient
Plt=1
AliasID=1
XExp=T
YExp=v($G_DGND)
XRng=1e-5
YRng=1,-0.25
Options=LINEARX,LINEARY
Range Grid X=2e-6
Range Grid Y=0.25
Enable=Enable
Line Color=#0000FF
Text Color=#0000FF
Rainbow=False
VFmtX=3
VFmtY=3
ScaleFactorX="None"
ScaleFactorY="None"
ScaleUnitsX="Auto"
ScaleUnitsY="Auto"
SFmtX=2
SFmtY=2
NOFmtX=3E
NOFmtY=3E

[WaveForm]
Analysis=Transient
Plt=1
AliasID=3
XExp=T
YExp=I(X2.D1)
XRng=1e-5
YRng=1,-0.25
Options=LINEARX,LINEARY
Range Grid X=2e-6
Range Grid Y=0.25
Enable=Enable
Line Color=#FF0000
Text Color=#FF0000
Rainbow=False
VFmtX=3
VFmtY=3
ScaleFactorX="None"
ScaleFactorY="None"
ScaleUnitsX="Auto"
ScaleUnitsY="Auto"
SFmtX=2
SFmtY=2
NOFmtX=3E
NOFmtY=3E

[WaveForm]
Analysis=Transient
Plt=1
AliasID=2
XExp=T
YExp=I(X5.D1)
XRng=1e-5
YRng=1,-0.25
Options=LINEARX,LINEARY
Range Grid X=2e-6
Range Grid Y=0.25
Enable=Enable
Line Color=#00FF00
Text Color=#00FF00
Rainbow=False
VFmtX=3
VFmtY=3
ScaleFactorX="None"
ScaleFactorY="None"
ScaleUnitsX="Auto"
ScaleUnitsY="Auto"
SFmtX=2
SFmtY=2
NOFmtX=3E
NOFmtY=3E

[WaveForm]
Analysis=Transient
Plt=1
AliasID=4
XExp=T
YExp=VB(Q2)
XRng=1e-5
YRng=1,-0.25
Options=LINEARX,LINEARY
Range Grid X=2e-6
Range Grid Y=0.25
Enable=Enable
Line Color=#008000
Text Color=#008000
Rainbow=False
VFmtX=3
VFmtY=3
ScaleFactorX="None"
ScaleFactorY="None"
ScaleUnitsX="Auto"
ScaleUnitsY="Auto"
SFmtX=2
SFmtY=2
NOFmtX=3E
NOFmtY=3E

[Limits]
Analysis=DC
I1Range=0.03,0,.001
I1=I1
NPts=51
Temp=27
MaxChng=5
StateVar=Zero
RunOption=Normal
Temperature Type=Linear
Accumulate Plots=False
IgnoreExprErrors=False
Sweep1 type=Auto
Sweep2 type=None

[WaveForm]
Analysis=DC
Plt=1
AliasID=1
XExp=DCINPUT1
YExp=v($G_DGND)
XRng=0.03
YRng=1,-1
Options=LINEARX,LINEARY
Range Grid X=0.006
Range Grid Y=0.5
Enable=Enable
Line Color=#0000FF
Text Color=#0000FF
Rainbow=False
VFmtX=3
VFmtY=3
ScaleFactorX="None"
ScaleFactorY="None"
ScaleUnitsX="Auto"
ScaleUnitsY="Auto"
SFmtX=2
SFmtY=2
NOFmtX=3E
NOFmtY=3E

[WaveForm]
Analysis=DC
AliasID=-1
Options=LINEARX,LINEARY
Enable=Enable
Line Color=#FF0000
Text Color=#FF0000
Rainbow=False
VFmtX=3
VFmtY=3
ScaleFactorX="None"
ScaleFactorY="None"
ScaleUnitsX="Auto"
ScaleUnitsY="Auto"
SFmtX=2
SFmtY=2
NOFmtX=3E
NOFmtY=3E

[WaveForm]
Analysis=DC
AliasID=-1
Options=LINEARX,LINEARY
Enable=Enable
Line Color=#008000
Text Color=#008000
Rainbow=False
VFmtX=3
VFmtY=3
ScaleFactorX="None"
ScaleFactorY="None"
ScaleUnitsX="Auto"
ScaleUnitsY="Auto"
SFmtX=2
SFmtY=2
NOFmtX=3E
NOFmtY=3E

[Limits]
Analysis=DynamicAC
FirstValueDisplay=Mag
SecondValueDisplay=PhaseDeg
PlaceText=True

[Limits]
Analysis=DynamicDC
PlaceText=True

[Pane]
Analysis=Transient
CurrentPage 0="MAIN"

[Pane]
Analysis=AC

[Pane]
Analysis=DC
CurrentPage 0="MAIN"

[Pane]
Analysis=HmDistortion

[Pane]
Analysis=ImDistortion

[Pane]
Analysis=Stability

[Watch]
Analysis=Transient
Format=3
ExprPercentWidth=80

[Watch]
Analysis=DC
Format=3
ExprPercentWidth=80

[SmokeWindow]
Analysis=Transient
Show Window=True
Window Placement=2,3, -1,-1, -8,-31, 260,260,1911,836
WinBackGround Color=#FFFFFF
Text=Height=-15,FStyle=0,Color=#000000,Name=Arial
Grid Color=#C0C0C0
Pass Color=#008000
Marginal Color=#FFFF00
Fail Color=#FF0000
Non-Valid Color=#E4E4E4
Sort Col=Percent
Sort Ascending=True
FormatRatedValue=3F
FormatPercentDerating=1F
FormatDeratedReliability=3F
FormatDeratedTemperature=3F
FormatMeasuredValue=3F
FormatPercentMax=1F
ShowPartsWithNoDotSmoke=False
ShowMouseTracker=True
ShowNonValid=True
ShowSigns=True
Width Valid=-1
Width Part=-1
Width Param=-1
Width Type=-1
Width Rated=-1
Width Derating=-1
Width Reliablity=-1
Width Temp=-1
Width Measured=-1
Width Percent=-1
UseFile=<Library>Standard.dlib
AVAILABLE_FILE=<Library>Standard.dlib

[WCTolerance]
Var Width=100
Nominal Width=72
Tol Width=152
Tol Name=Drift
Col Width Neq=50
Col Width Pos=50
Col Width Rnd=50

[WCFiles]
UseFile=<Library>Standard.tlib
AVAILABLE_FILE=<Library>Standard.tlib

[OPMethods]
Analysis=Transient
Standard Newton-Raphson=0,0
Source Stepping=0,0
Diagonal Gmin Stepping=0,0
Junction Gmin Stepping=0,0
Pseudo Transient=0,0

[OPMethods]
Analysis=AC
Standard Newton-Raphson=0,0
Source Stepping=0,0
Diagonal Gmin Stepping=0,0
Junction Gmin Stepping=0,0
Pseudo Transient=0,0

[OPMethods]
Analysis=DC
Standard Newton-Raphson=0,0
Source Stepping=0,0
Diagonal Gmin Stepping=0,0
Junction Gmin Stepping=0,0
Pseudo Transient=0,0
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
