lkolbly/ledgrid/hw-v2/high_side_driver_simulation.asc

I1: current; 800m
Q1: npn; 2N2222
Q2: pnp; 2N2907
Q3: npn; 2N2222
Q4: pnp; 2N2907
R1: res; 1k
R2: res; 1k
R3: res; 1k
R4: res; 1k
V1: voltage; 3.3
V2: voltage; 12
V3: voltage; 0
V4: voltage; 12
Named nets: 0
.op
