lkolbly/ledgrid/(list of files, drawings)

Other design files:
hw/connector.pcb
hw/ledgrid.base.pcb
hw/ledgrid.pcb
hw/shifterboard.pcb
