lkolbly/ledgrid/hw-v2/pogoboard/ledgrid_programmer.kicad_pcb

## KiCad design hw-v2/pogoboard/ledgrid_programmer.kicad_pcb (2020-03-08)

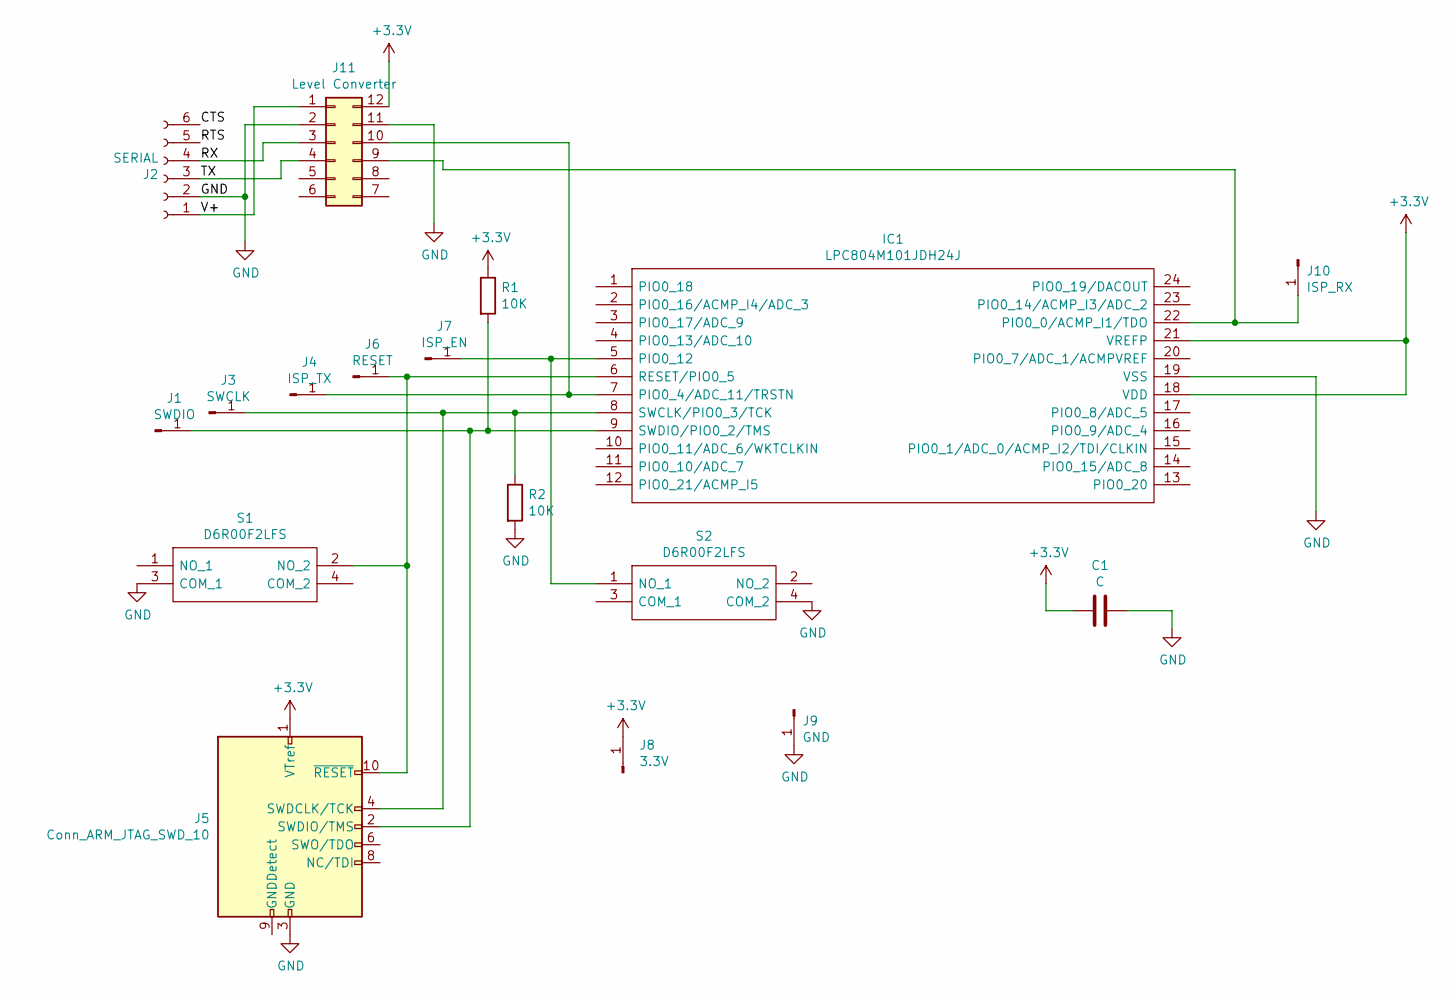
[picture p1: schematic ledgrid_programmer.sch]

Parts:
C1: C; C_0805_2012Metric_Pad1.15x1.40mm_HandSolder
IC1: LPC804M101JDH24J; SOP65P640X110-24N; Manufacturer_Part_Number LPC804M101JDH24J
J1: SWDIO; PinHeader_1x01_P2.54mm_Vertical
J2: SERIAL; PinHeader_1x06_P2.54mm_Vertical
J3: SWCLK; PinHeader_1x01_P2.54mm_Vertical
J4: ISP_TX; PinHeader_1x01_P2.54mm_Vertical
J5: Conn_ARM_JTAG_SWD_10; PinHeader_2x05_P2.54mm_Vertical
J6: RESET; PinHeader_1x01_P2.54mm_Vertical
J7: ISP_EN; PinHeader_1x01_P2.54mm_Vertical
J8: 3.3V; PinHeader_1x01_P2.54mm_Vertical
J9: GND; PinHeader_1x01_P2.54mm_Vertical
J10: ISP_RX; PinHeader_1x01_P2.54mm_Vertical
J11: Level Converter; DIP-12_W10.16mm
R1, R2: 10K; R_Axial_DIN0207_L6.3mm_D2.5mm_P7.62mm_Horizontal
S1, S2: D6R00F2LFS; Mouser Part Number 611-D6R00F2LFS

Connections:
+3V3: C1.2, IC1.18 (VDD), IC1.21 (VREFP), J5.1 (VTref), J8.1, J11.12, R1.1
/CTS: J2.6
/RTS: J2.5
/RX: J2.4, J11.3
/TX: J2.3, J11.4
/V+: J2.1, J11.1
GND: C1.1, IC1.19 (VSS), J2.2, J5.3 (GND), J5.5 (GND), J9.1, J11.2, J11.11, R2.2, S1.3 (COM_1), S2.4 (COM_2)
unnamed: IC1.5 (PIO0_12), J7.1, S2.1 (NO_1)
unnamed: IC1.6 (RESET/PIO0_5), J5.10 (~RESET~), J6.1, S1.2 (NO_2)
unnamed: IC1.7 (PIO0_4/ADC_11/TRSTN), J4.1, J11.10
unnamed: IC1.8 (SWCLK/PIO0_3/TCK), J3.1, J5.4 (SWDCLK/TCK), R2.1
unnamed: IC1.9 (SWDIO/PIO0_2/TMS), J1.1, J5.2 (SWDIO/TMS), R1.2
unnamed: IC1.22 (PIO0_0/ACMP_I1/TDO), J10.1, J11.9

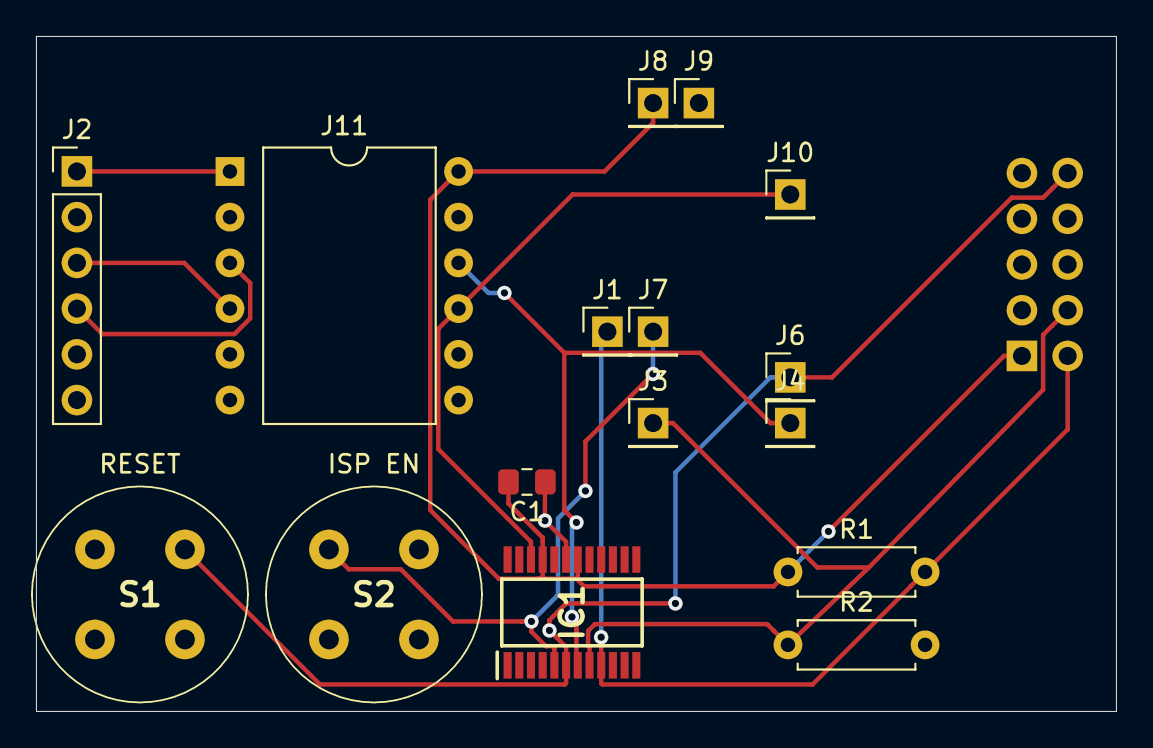
[picture p2: board ledgrid_programmer.kicad_pcb from above]

Board: 2 copper layers, 60.0 x 37.5 mm, 17 parts (1 on the bottom side), 11 nets.
