lkolbly/ledgrid/hw-v2/ledgrid.kicad_pcb

## KiCad design hw-v2/ledgrid.kicad_pcb (2020-03-08)

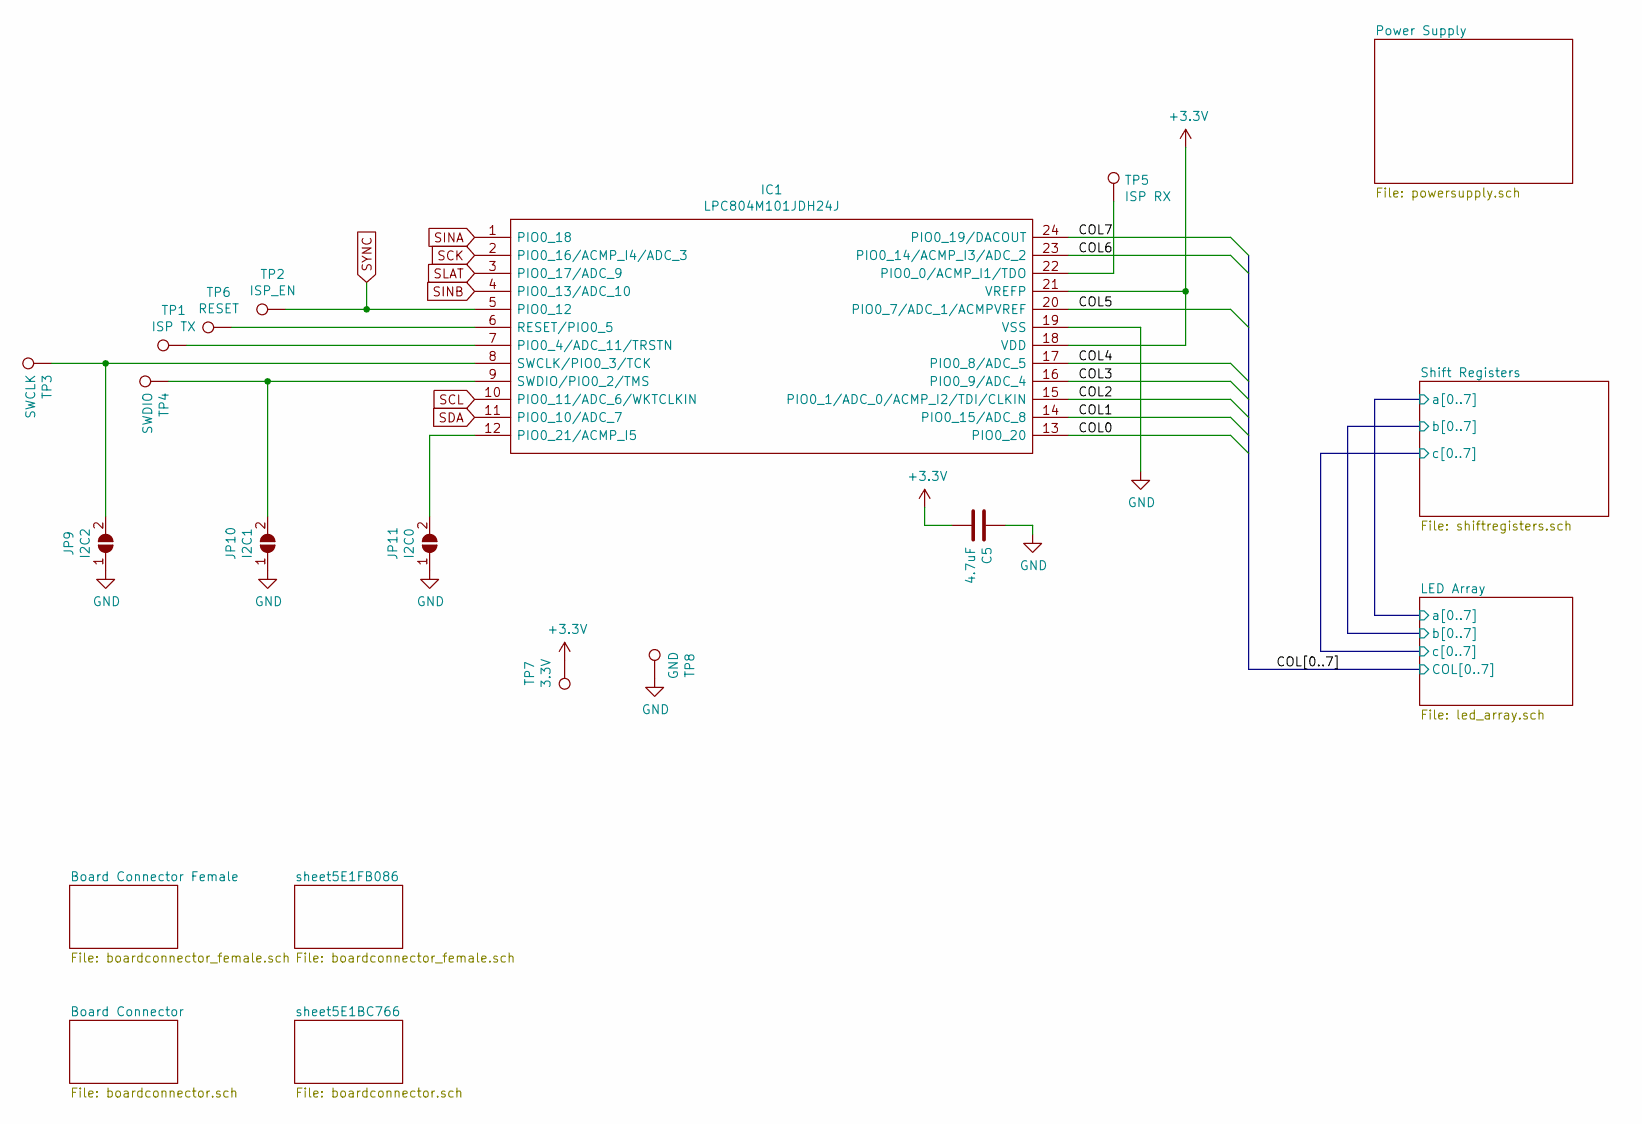
[picture p3: schematic ledgrid.sch]

Parts:
C5: 4.7uF; C_0805_2012Metric
IC1: LPC804M101JDH24J; SOP65P640X110-24N; Manufacturer_Part_Number LPC804M101JDH24J
JP9: I2C2; SolderJumper-2_P1.3mm_Open_RoundedPad1.0x1.5mm
JP10: I2C1; SolderJumper-2_P1.3mm_Open_RoundedPad1.0x1.5mm
JP11: I2C0; SolderJumper-2_P1.3mm_Open_RoundedPad1.0x1.5mm
TP1: ISP TX; TestPoint_Pad_D1.0mm
TP2: ISP_EN; TestPoint_Pad_D1.0mm
TP3: SWCLK; TestPoint_Pad_D1.0mm
TP4: SWDIO; TestPoint_Pad_D1.0mm
TP5: ISP RX; TestPoint_Pad_D1.0mm
TP6: RESET; TestPoint_Pad_D1.0mm
TP7: 3.3V; TestPoint_Pad_D1.0mm
TP8: GND; TestPoint_Pad_D1.0mm

Connections:
+3V3: C5.2, IC1.18 (VDD), IC1.21 (VREFP), TP7.1; also elsewhere on the board
/COL0: IC1.13 (PIO0_20); also elsewhere on the board
/COL1: IC1.14 (PIO0_15/ADC_8); also elsewhere on the board
/COL2: IC1.15 (PIO0_1/ADC_0/ACMP_I2/TDI/CLKIN); also elsewhere on the board
/COL3: IC1.16 (PIO0_9/ADC_4); also elsewhere on the board
/COL4: IC1.17 (PIO0_8/ADC_5); also elsewhere on the board
/COL5: IC1.20 (PIO0_7/ADC_1/ACMPVREF); also elsewhere on the board
/COL6: IC1.23 (PIO0_14/ACMP_I3/ADC_2); also elsewhere on the board
/COL7: IC1.24 (PIO0_19/DACOUT); also elsewhere on the board
GND: C5.1, IC1.19 (VSS), JP9.1 (A), JP10.1 (A), JP11.1 (A), TP8.1; also elsewhere on the board
unnamed: IC1.6 (RESET/PIO0_5), TP6.1
unnamed: IC1.7 (PIO0_4/ADC_11/TRSTN), TP1.1
unnamed: IC1.8 (SWCLK/PIO0_3/TCK), JP9.2 (B), TP3.1
unnamed: IC1.9 (SWDIO/PIO0_2/TMS), JP10.2 (B), TP4.1
unnamed: IC1.12 (PIO0_21/ACMP_I5), JP11.2 (B)
unnamed: IC1.22 (PIO0_0/ACMP_I1/TDO), TP5.1
SCK: IC1.2 (PIO0_16/ACMP_I4/ADC_3); also elsewhere on the board
SCL: IC1.10 (PIO0_11/ADC_6/WKTCLKIN); also elsewhere on the board
SDA: IC1.11 (PIO0_10/ADC_7); also elsewhere on the board
SINA: IC1.1 (PIO0_18); also elsewhere on the board
SINB: IC1.4 (PIO0_13/ADC_10); also elsewhere on the board
SLAT: IC1.3 (PIO0_17/ADC_9); also elsewhere on the board
SYNC: IC1.5 (PIO0_12), TP2.1; also elsewhere on the board

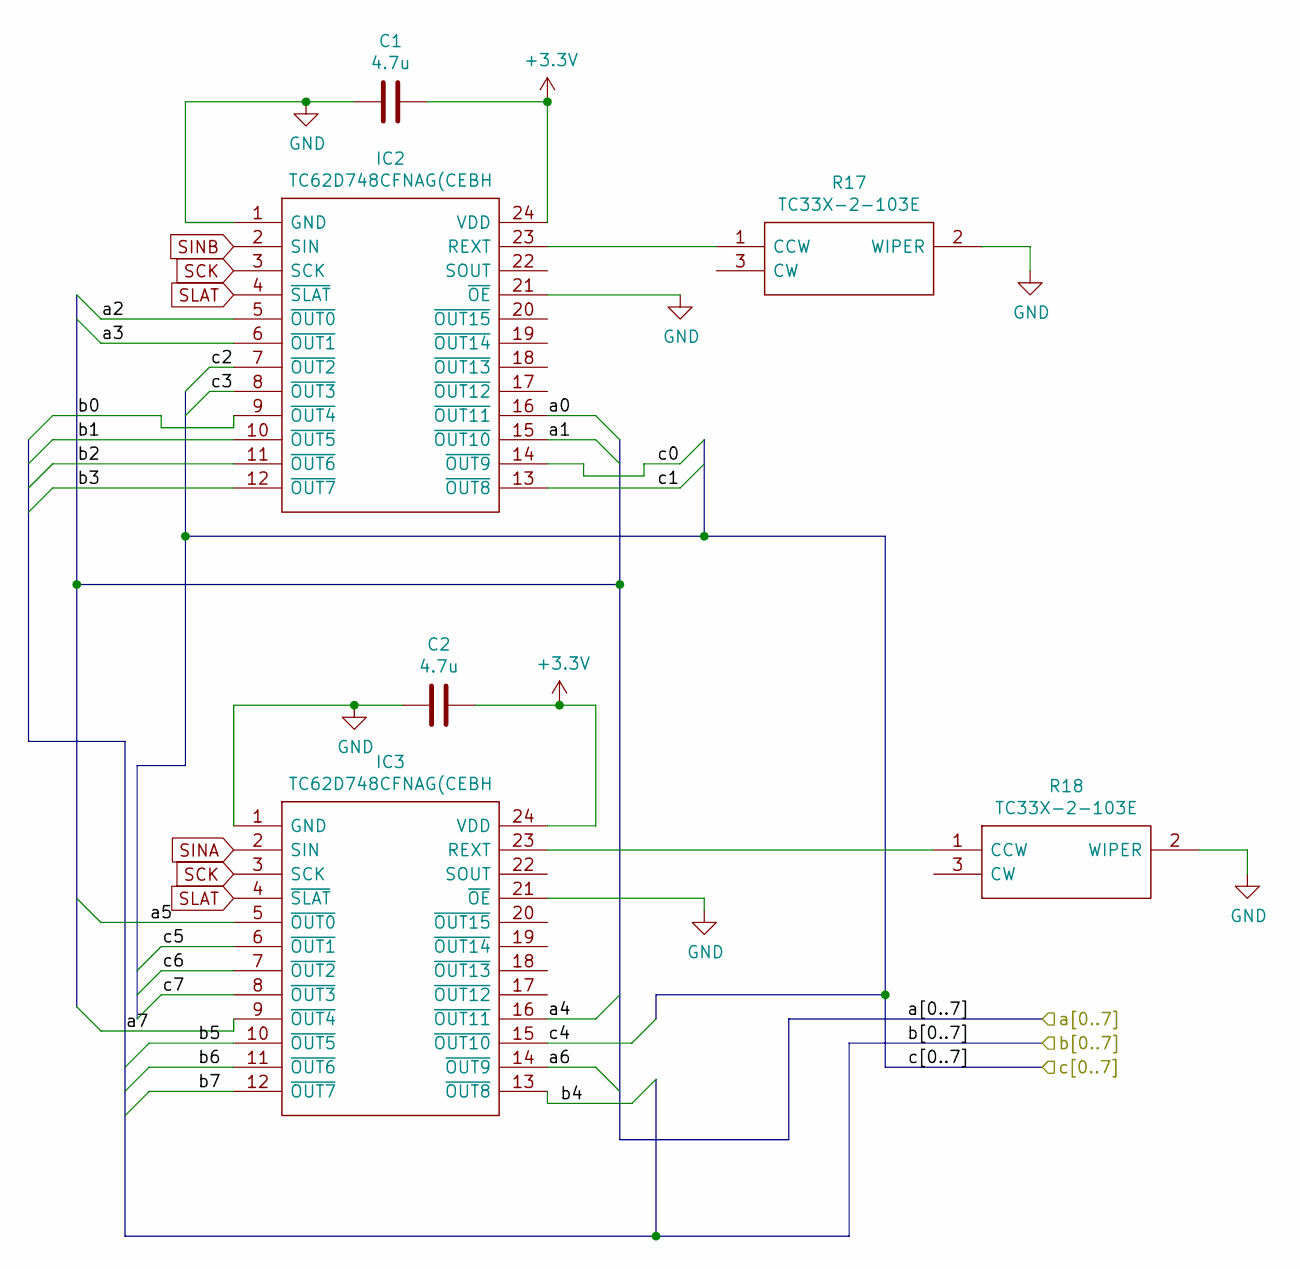
[picture p4: schematic shiftregisters.sch]

Parts:
C1, C2: 4.7u; C_0805_2012Metric
IC2, IC3: TC62D748CFNAG(CEBH; SOP64P600X175-24N; Mouser Part Number 757-TC62D748CFNAGCEB
R17, R18: TC33X-2-103E; TC33X-2_1; Mouser Part Number 652-TC33X-2-103E

Connections:
+3V3: C1.1, C2.1, IC2.24 (VDD), IC3.24 (VDD); also elsewhere on the board
/Shift Registers/a0: IC2.16 (~OUT11); also elsewhere on the board
/Shift Registers/a1: IC2.15 (~OUT10); also elsewhere on the board
/Shift Registers/a2: IC2.5 (~OUT0); also elsewhere on the board
/Shift Registers/a3: IC2.6 (~OUT1); also elsewhere on the board
/Shift Registers/a4: IC3.16 (~OUT11); also elsewhere on the board
/Shift Registers/a5: IC3.5 (~OUT0); also elsewhere on the board
/Shift Registers/a6: IC3.14 (~OUT9); also elsewhere on the board
/Shift Registers/a7: IC3.9 (~OUT4); also elsewhere on the board
/Shift Registers/b0: IC2.9 (~OUT4); also elsewhere on the board
/Shift Registers/b1: IC2.10 (~OUT5); also elsewhere on the board
/Shift Registers/b2: IC2.11 (~OUT6); also elsewhere on the board
/Shift Registers/b3: IC2.12 (~OUT7); also elsewhere on the board
/Shift Registers/b4: IC3.13 (~OUT8); also elsewhere on the board
/Shift Registers/b5: IC3.10 (~OUT5); also elsewhere on the board
/Shift Registers/b6: IC3.11 (~OUT6); also elsewhere on the board
/Shift Registers/b7: IC3.12 (~OUT7); also elsewhere on the board
/Shift Registers/c0: IC2.14 (~OUT9); also elsewhere on the board
/Shift Registers/c1: IC2.13 (~OUT8); also elsewhere on the board
/Shift Registers/c2: IC2.7 (~OUT2); also elsewhere on the board
/Shift Registers/c3: IC2.8 (~OUT3); also elsewhere on the board
/Shift Registers/c4: IC3.15 (~OUT10); also elsewhere on the board
/Shift Registers/c5: IC3.6 (~OUT1); also elsewhere on the board
/Shift Registers/c6: IC3.7 (~OUT2); also elsewhere on the board
/Shift Registers/c7: IC3.8 (~OUT3); also elsewhere on the board
GND: C1.2, C2.2, IC2.1 (GND), IC2.21 (~OE), IC3.1 (GND), IC3.21 (~OE), R17.2 (WIPER), R18.2 (WIPER); also elsewhere on the board
unnamed: IC2.23 (REXT), R17.1 (CCW)
unnamed: IC3.23 (REXT), R18.1 (CCW)
SCK: IC2.3 (SCK), IC3.3 (SCK); also elsewhere on the board
SINA: IC3.2 (SIN); also elsewhere on the board
SINB: IC2.2 (SIN); also elsewhere on the board
SLAT: IC2.4 (~SLAT), IC3.4 (~SLAT); also elsewhere on the board

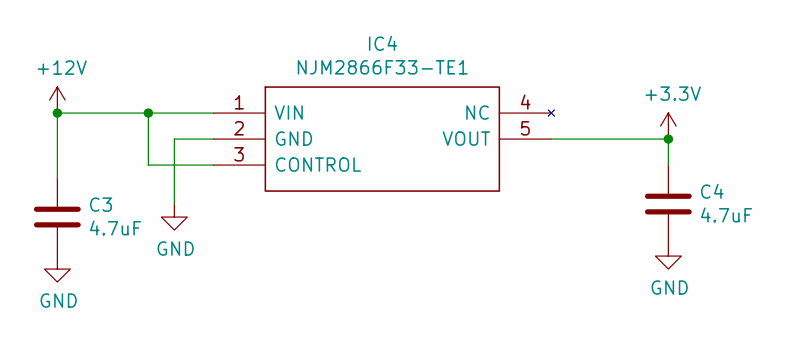
[picture p5: schematic powersupply.sch]

Parts:
C3, C4: 4.7uF; C_0805_2012Metric
IC4: NJM2866F33-TE1; SOT95P280X130-5N; Mouser Part Number 513-NJM2866F33-TE1

Connections:
+3V3: C4.1, IC4.5 (VOUT); also elsewhere on the board
+12V: C3.1, IC4.1 (VIN), IC4.3 (CONTROL); also elsewhere on the board
GND: C3.2, C4.2, IC4.2 (GND); also elsewhere on the board

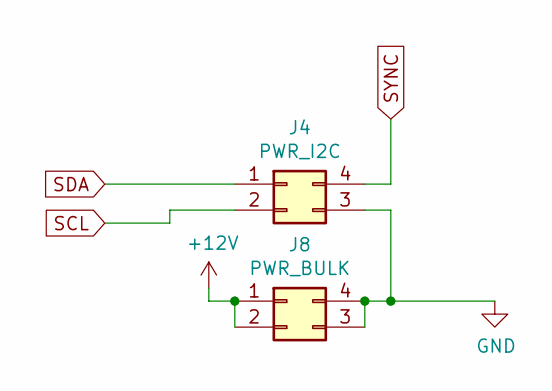
[picture p6: schematic boardconnector.sch]

Parts:
J1: PWR_I2C; PinHeader_2x02_P2.54mm_Horizontal
J5: PWR_BULK; PinHeader_2x02_P2.54mm_Horizontal

Connections:
+12V: J5.1, J5.2; also elsewhere on the board
GND: J1.3, J5.3, J5.4; also elsewhere on the board
SCL: J1.2; also elsewhere on the board
SDA: J1.1; also elsewhere on the board
SYNC: J1.4; also elsewhere on the board

Parts of its further copies:
J4: PWR_I2C; PinHeader_2x02_P2.54mm_Horizontal
J7, J8: PWR_BULK; PinHeader_2x02_P2.54mm_Horizontal

Connections of its further copies:
+12V: J7.3, J7.4, J8.1, J8.2; also elsewhere on the board
GND: J4.3, J7.1, J7.2, J8.3, J8.4; also elsewhere on the board
SCL: J4.2; also elsewhere on the board
SDA: J4.1; also elsewhere on the board
SYNC: J4.4; also elsewhere on the board

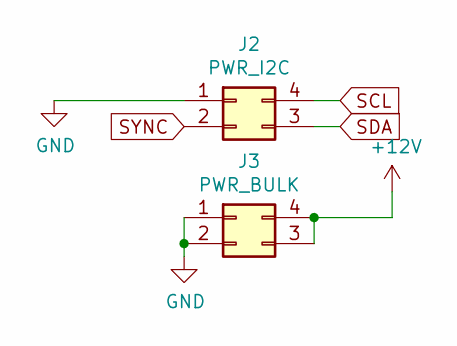
[picture p7: schematic boardconnector_female.sch]

Parts:
J2: PWR_I2C; PinHeader_2x02_P2.54mm_Horizontal
J3: PWR_BULK; PinHeader_2x02_P2.54mm_Horizontal

Connections:
+12V: J3.3, J3.4; also elsewhere on the board
GND: J2.1, J3.1, J3.2; also elsewhere on the board
SCL: J2.4; also elsewhere on the board
SDA: J2.3; also elsewhere on the board
SYNC: J2.2; also elsewhere on the board

Parts of its further copies:
J6: PWR_I2C; PinHeader_2x02_P2.54mm_Horizontal
J7: PWR_BULK; PinHeader_2x02_P2.54mm_Horizontal

Connections of its further copies:
+12V: J7.3, J7.4; also elsewhere on the board
GND: J6.1, J7.1, J7.2; also elsewhere on the board
SCL: J6.4; also elsewhere on the board
SDA: J6.3; also elsewhere on the board
SYNC: J6.2; also elsewhere on the board

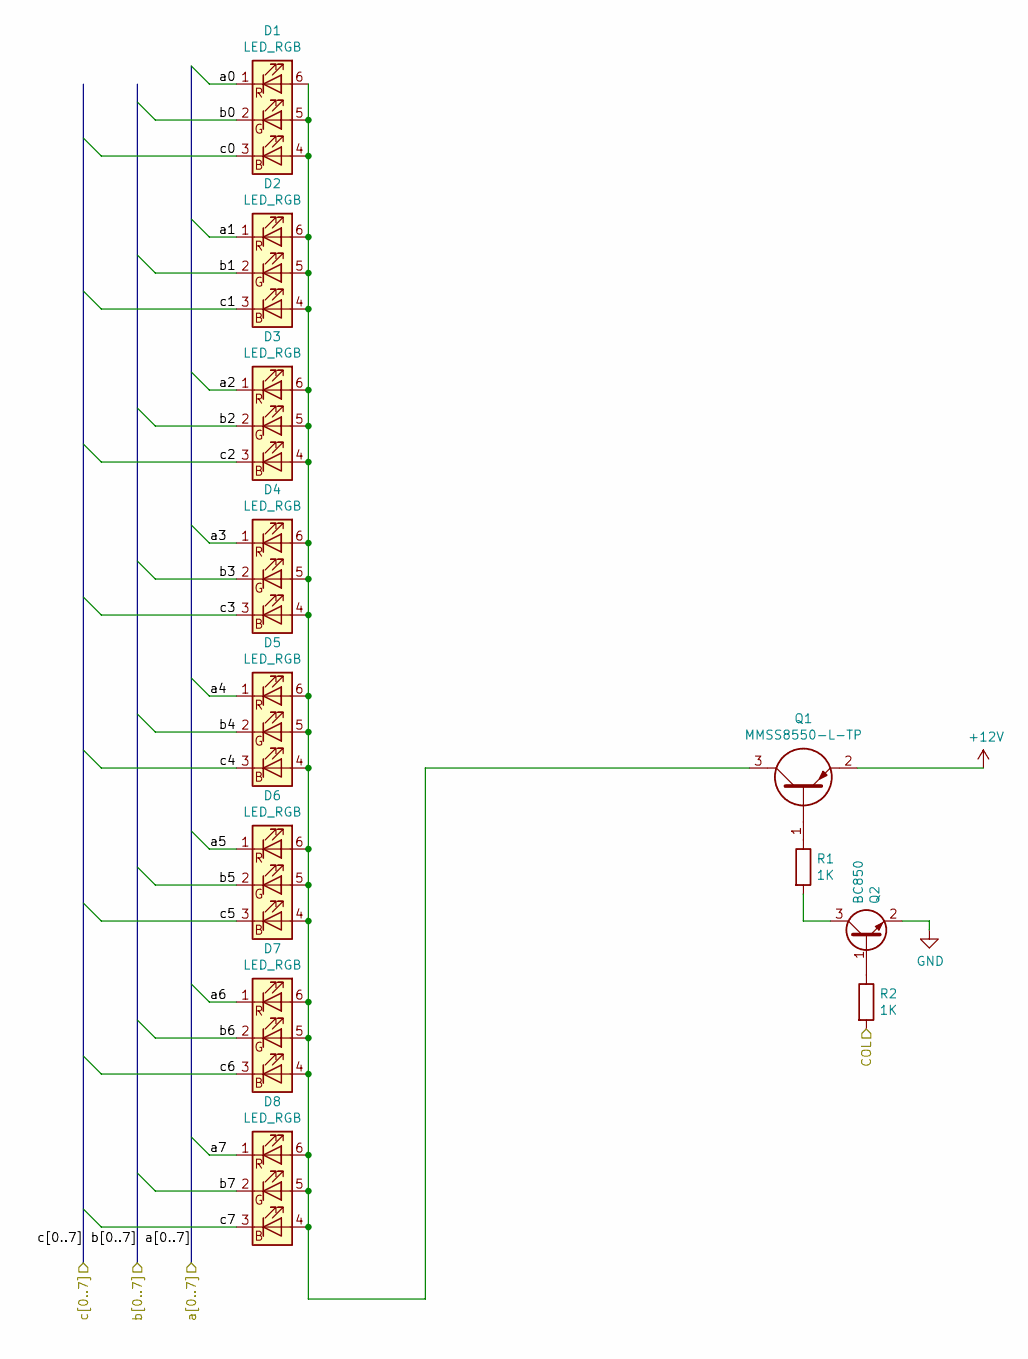
[picture p8: schematic led_column.sch]

Parts:
D2, D3, D4, D5, D6, D7, D8, D9: LED_RGB; LED_RGB_5050-6
Q1: MMSS8550-L-TP; SOT96P237X122-3N; Mouser Part Number 833-MMSS8550-L-TP
Q2: BC850; SOT-23
R1, R2: 1K; R_0805_2012Metric

Connections:
+12V: Q1.2; also elsewhere on the board
/COL0: R2.2; also elsewhere on the board
/Shift Registers/a0: D9.1 (RK); also elsewhere on the board
/Shift Registers/a1: D2.1 (RK); also elsewhere on the board
/Shift Registers/a2: D3.1 (RK); also elsewhere on the board
/Shift Registers/a3: D4.1 (RK); also elsewhere on the board
/Shift Registers/a4: D5.1 (RK); also elsewhere on the board
/Shift Registers/a5: D6.1 (RK); also elsewhere on the board
/Shift Registers/a6: D7.1 (RK); also elsewhere on the board
/Shift Registers/a7: D8.1 (RK); also elsewhere on the board
/Shift Registers/b0: D9.2 (GK); also elsewhere on the board
/Shift Registers/b1: D2.2 (GK); also elsewhere on the board
/Shift Registers/b2: D3.2 (GK); also elsewhere on the board
/Shift Registers/b3: D4.2 (GK); also elsewhere on the board
/Shift Registers/b4: D5.2 (GK); also elsewhere on the board
/Shift Registers/b5: D6.2 (GK); also elsewhere on the board
/Shift Registers/b6: D7.2 (GK); also elsewhere on the board
/Shift Registers/b7: D8.2 (GK); also elsewhere on the board
/Shift Registers/c0: D9.3 (BK); also elsewhere on the board
/Shift Registers/c1: D2.3 (BK); also elsewhere on the board
/Shift Registers/c2: D3.3 (BK); also elsewhere on the board
/Shift Registers/c3: D4.3 (BK); also elsewhere on the board
/Shift Registers/c4: D5.3 (BK); also elsewhere on the board
/Shift Registers/c5: D6.3 (BK); also elsewhere on the board
/Shift Registers/c6: D7.3 (BK); also elsewhere on the board
/Shift Registers/c7: D8.3 (BK); also elsewhere on the board
GND: Q2.2 (E); also elsewhere on the board
unnamed: Q1.1, R1.1
unnamed: Q2.1 (B), R2.1
unnamed: Q2.3 (C), R1.2

Parts of its further copies:
D1, D10, D11, D12, D13, D14, D15, D16, D17, D18, D19, D20, D21, D22, D23, D24, D25, D26, D27, D28, D29, D30, D31, D32, D33, D34, D35, D36, D37, D38, D39, D40, D41, D42, D43, D44, D45, D46, D47, D48, D49, D50, D51, D52, D53, D54, D55, D56, D57, D58, D59, D60, D61, D62, D63, D64: LED_RGB; LED_RGB_5050-6
Q3, Q5, Q7, Q9, Q11, Q13, Q15: MMSS8550-L-TP; SOT96P237X122-3N; Mouser Part Number 833-MMSS8550-L-TP
Q4, Q6, Q8, Q10, Q12, Q14, Q16: BC850; SOT-23
R3, R4, R5, R6, R7, R8, R9, R10, R11, R12, R13, R14, R15, R16: 1K; R_0805_2012Metric

Connections of its further copies:
+12V: Q3.2, Q5.2, Q7.2, Q9.2, Q11.2, Q13.2, Q15.2; also elsewhere on the board
/COL1: R4.2; also elsewhere on the board
/COL2: R6.2; also elsewhere on the board
/COL3: R8.2; also elsewhere on the board
/COL4: R10.2; also elsewhere on the board
/COL5: R12.2; also elsewhere on the board
/COL6: R14.2; also elsewhere on the board
/COL7: R16.2; also elsewhere on the board
/Shift Registers/a0: D1.1 (RK), D17.1 (RK), D25.1 (RK), D33.1 (RK), D41.1 (RK), D49.1 (RK), D57.1 (RK); also elsewhere on the board
/Shift Registers/a1: D10.1 (RK), D18.1 (RK), D26.1 (RK), D34.1 (RK), D42.1 (RK), D50.1 (RK), D58.1 (RK); also elsewhere on the board
/Shift Registers/a2: D11.1 (RK), D19.1 (RK), D27.1 (RK), D35.1 (RK), D43.1 (RK), D51.1 (RK), D59.1 (RK); also elsewhere on the board
/Shift Registers/a3: D12.1 (RK), D20.1 (RK), D28.1 (RK), D36.1 (RK), D44.1 (RK), D52.1 (RK), D60.1 (RK); also elsewhere on the board
/Shift Registers/a4: D13.1 (RK), D21.1 (RK), D29.1 (RK), D37.1 (RK), D45.1 (RK), D53.1 (RK), D61.1 (RK); also elsewhere on the board
/Shift Registers/a5: D14.1 (RK), D22.1 (RK), D30.1 (RK), D38.1 (RK), D46.1 (RK), D54.1 (RK), D62.1 (RK); also elsewhere on the board
/Shift Registers/a6: D15.1 (RK), D23.1 (RK), D31.1 (RK), D39.1 (RK), D47.1 (RK), D55.1 (RK), D63.1 (RK); also elsewhere on the board
/Shift Registers/a7: D16.1 (RK), D24.1 (RK), D32.1 (RK), D40.1 (RK), D48.1 (RK), D56.1 (RK), D64.1 (RK); also elsewhere on the board
/Shift Registers/b0: D1.2 (GK), D17.2 (GK), D25.2 (GK), D33.2 (GK), D41.2 (GK), D49.2 (GK), D57.2 (GK); also elsewhere on the board
/Shift Registers/b1: D10.2 (GK), D18.2 (GK), D26.2 (GK), D34.2 (GK), D42.2 (GK), D50.2 (GK), D58.2 (GK); also elsewhere on the board
/Shift Registers/b2: D11.2 (GK), D19.2 (GK), D27.2 (GK), D35.2 (GK), D43.2 (GK), D51.2 (GK), D59.2 (GK); also elsewhere on the board
/Shift Registers/b3: D12.2 (GK), D20.2 (GK), D28.2 (GK), D36.2 (GK), D44.2 (GK), D52.2 (GK), D60.2 (GK); also elsewhere on the board
/Shift Registers/b4: D13.2 (GK), D21.2 (GK), D29.2 (GK), D37.2 (GK), D45.2 (GK), D53.2 (GK), D61.2 (GK); also elsewhere on the board
/Shift Registers/b5: D14.2 (GK), D22.2 (GK), D30.2 (GK), D38.2 (GK), D46.2 (GK), D54.2 (GK), D62.2 (GK); also elsewhere on the board
/Shift Registers/b6: D15.2 (GK), D23.2 (GK), D31.2 (GK), D39.2 (GK), D47.2 (GK), D55.2 (GK), D63.2 (GK); also elsewhere on the board
/Shift Registers/b7: D16.2 (GK), D24.2 (GK), D32.2 (GK), D40.2 (GK), D48.2 (GK), D56.2 (GK), D64.2 (GK); also elsewhere on the board
/Shift Registers/c0: D1.3 (BK), D17.3 (BK), D25.3 (BK), D33.3 (BK), D41.3 (BK), D49.3 (BK), D57.3 (BK); also elsewhere on the board
/Shift Registers/c1: D10.3 (BK), D18.3 (BK), D26.3 (BK), D34.3 (BK), D42.3 (BK), D50.3 (BK), D58.3 (BK); also elsewhere on the board
/Shift Registers/c2: D11.3 (BK), D19.3 (BK), D27.3 (BK), D35.3 (BK), D43.3 (BK), D51.3 (BK), D59.3 (BK); also elsewhere on the board
/Shift Registers/c3: D12.3 (BK), D20.3 (BK), D28.3 (BK), D36.3 (BK), D44.3 (BK), D52.3 (BK), D60.3 (BK); also elsewhere on the board
/Shift Registers/c4: D13.3 (BK), D21.3 (BK), D29.3 (BK), D37.3 (BK), D45.3 (BK), D53.3 (BK), D61.3 (BK); also elsewhere on the board
/Shift Registers/c5: D14.3 (BK), D22.3 (BK), D30.3 (BK), D38.3 (BK), D46.3 (BK), D54.3 (BK), D62.3 (BK); also elsewhere on the board
/Shift Registers/c6: D15.3 (BK), D23.3 (BK), D31.3 (BK), D39.3 (BK), D47.3 (BK), D55.3 (BK), D63.3 (BK); also elsewhere on the board
/Shift Registers/c7: D16.3 (BK), D24.3 (BK), D32.3 (BK), D40.3 (BK), D48.3 (BK), D56.3 (BK), D64.3 (BK); also elsewhere on the board
GND: Q4.2 (E), Q6.2 (E), Q8.2 (E), Q10.2 (E), Q12.2 (E), Q14.2 (E), Q16.2 (E); also elsewhere on the board
unnamed: D17.4 (BA), D17.5 (GA), D17.6 (RA), D18.4 (BA), D18.5 (GA), D18.6 (RA), D19.4 (BA), D19.5 (GA), D19.6 (RA), D20.4 (BA), D20.5 (GA), D20.6 (RA), D21.4 (BA), D21.5 (GA), D21.6 (RA), D22.4 (BA), D22.5 (GA), D22.6 (RA), D23.4 (BA), D23.5 (GA), D23.6 (RA), D24.4 (BA), D24.5 (GA), D24.6 (RA), Q5.3
unnamed: D25.4 (BA), D25.5 (GA), D25.6 (RA), D26.4 (BA), D26.5 (GA), D26.6 (RA), D27.4 (BA), D27.5 (GA), D27.6 (RA), D28.4 (BA), D28.5 (GA), D28.6 (RA), D29.4 (BA), D29.5 (GA), D29.6 (RA), D30.4 (BA), D30.5 (GA), D30.6 (RA), D31.4 (BA), D31.5 (GA), D31.6 (RA), D32.4 (BA), D32.5 (GA), D32.6 (RA), Q7.3
unnamed: D33.4 (BA), D33.5 (GA), D33.6 (RA), D34.4 (BA), D34.5 (GA), D34.6 (RA), D35.4 (BA), D35.5 (GA), D35.6 (RA), D36.4 (BA), D36.5 (GA), D36.6 (RA), D37.4 (BA), D37.5 (GA), D37.6 (RA), D38.4 (BA), D38.5 (GA), D38.6 (RA), D39.4 (BA), D39.5 (GA), D39.6 (RA), D40.4 (BA), D40.5 (GA), D40.6 (RA), Q9.3
unnamed: D41.4 (BA), D41.5 (GA), D41.6 (RA), D42.4 (BA), D42.5 (GA), D42.6 (RA), D43.4 (BA), D43.5 (GA), D43.6 (RA), D44.4 (BA), D44.5 (GA), D44.6 (RA), D45.4 (BA), D45.5 (GA), D45.6 (RA), D46.4 (BA), D46.5 (GA), D46.6 (RA), D47.4 (BA), D47.5 (GA), D47.6 (RA), D48.4 (BA), D48.5 (GA), D48.6 (RA), Q11.3
unnamed: D49.4 (BA), D49.5 (GA), D49.6 (RA), D50.4 (BA), D50.5 (GA), D50.6 (RA), D51.4 (BA), D51.5 (GA), D51.6 (RA), D52.4 (BA), D52.5 (GA), D52.6 (RA), D53.4 (BA), D53.5 (GA), D53.6 (RA), D54.4 (BA), D54.5 (GA), D54.6 (RA), D55.4 (BA), D55.5 (GA), D55.6 (RA), D56.4 (BA), D56.5 (GA), D56.6 (RA), Q13.3
unnamed: D57.4 (BA), D57.5 (GA), D57.6 (RA), D58.4 (BA), D58.5 (GA), D58.6 (RA), D59.4 (BA), D59.5 (GA), D59.6 (RA), D60.4 (BA), D60.5 (GA), D60.6 (RA), D61.4 (BA), D61.5 (GA), D61.6 (RA), D62.4 (BA), D62.5 (GA), D62.6 (RA), D63.4 (BA), D63.5 (GA), D63.6 (RA), D64.4 (BA), D64.5 (GA), D64.6 (RA), Q15.3
unnamed: Q3.1, R3.1
unnamed: Q4.1 (B), R4.1
unnamed: Q4.3 (C), R3.2
unnamed: Q5.1, R5.1
unnamed: Q6.1 (B), R6.1
unnamed: Q6.3 (C), R5.2
unnamed: Q7.1, R7.1
unnamed: Q8.1 (B), R8.1
unnamed: Q8.3 (C), R7.2
unnamed: Q9.1, R9.1
unnamed: Q10.1 (B), R10.1
unnamed: Q10.3 (C), R9.2
unnamed: Q11.1, R11.1
unnamed: Q12.1 (B), R12.1
unnamed: Q12.3 (C), R11.2
unnamed: Q13.1, R13.1
unnamed: Q14.1 (B), R14.1
unnamed: Q14.3 (C), R13.2
unnamed: Q15.1, R15.1
unnamed: Q16.1 (B), R16.1
unnamed: Q16.3 (C), R15.2

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
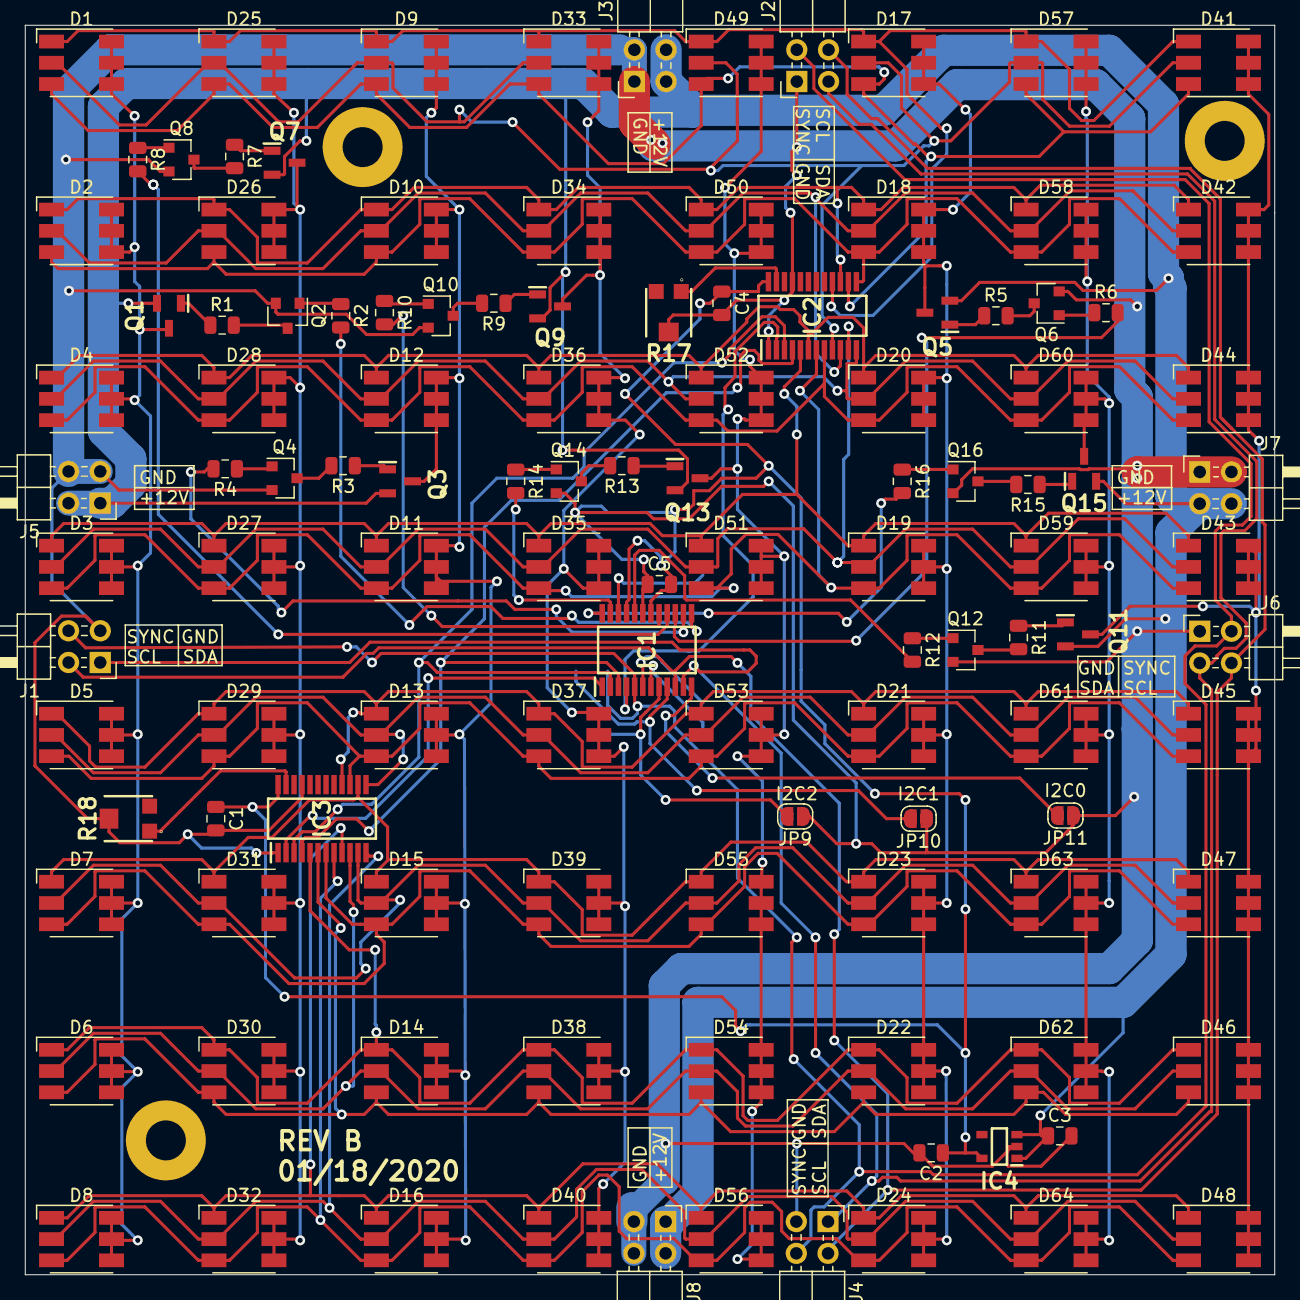
[picture p9: board ledgrid.kicad_pcb from above]

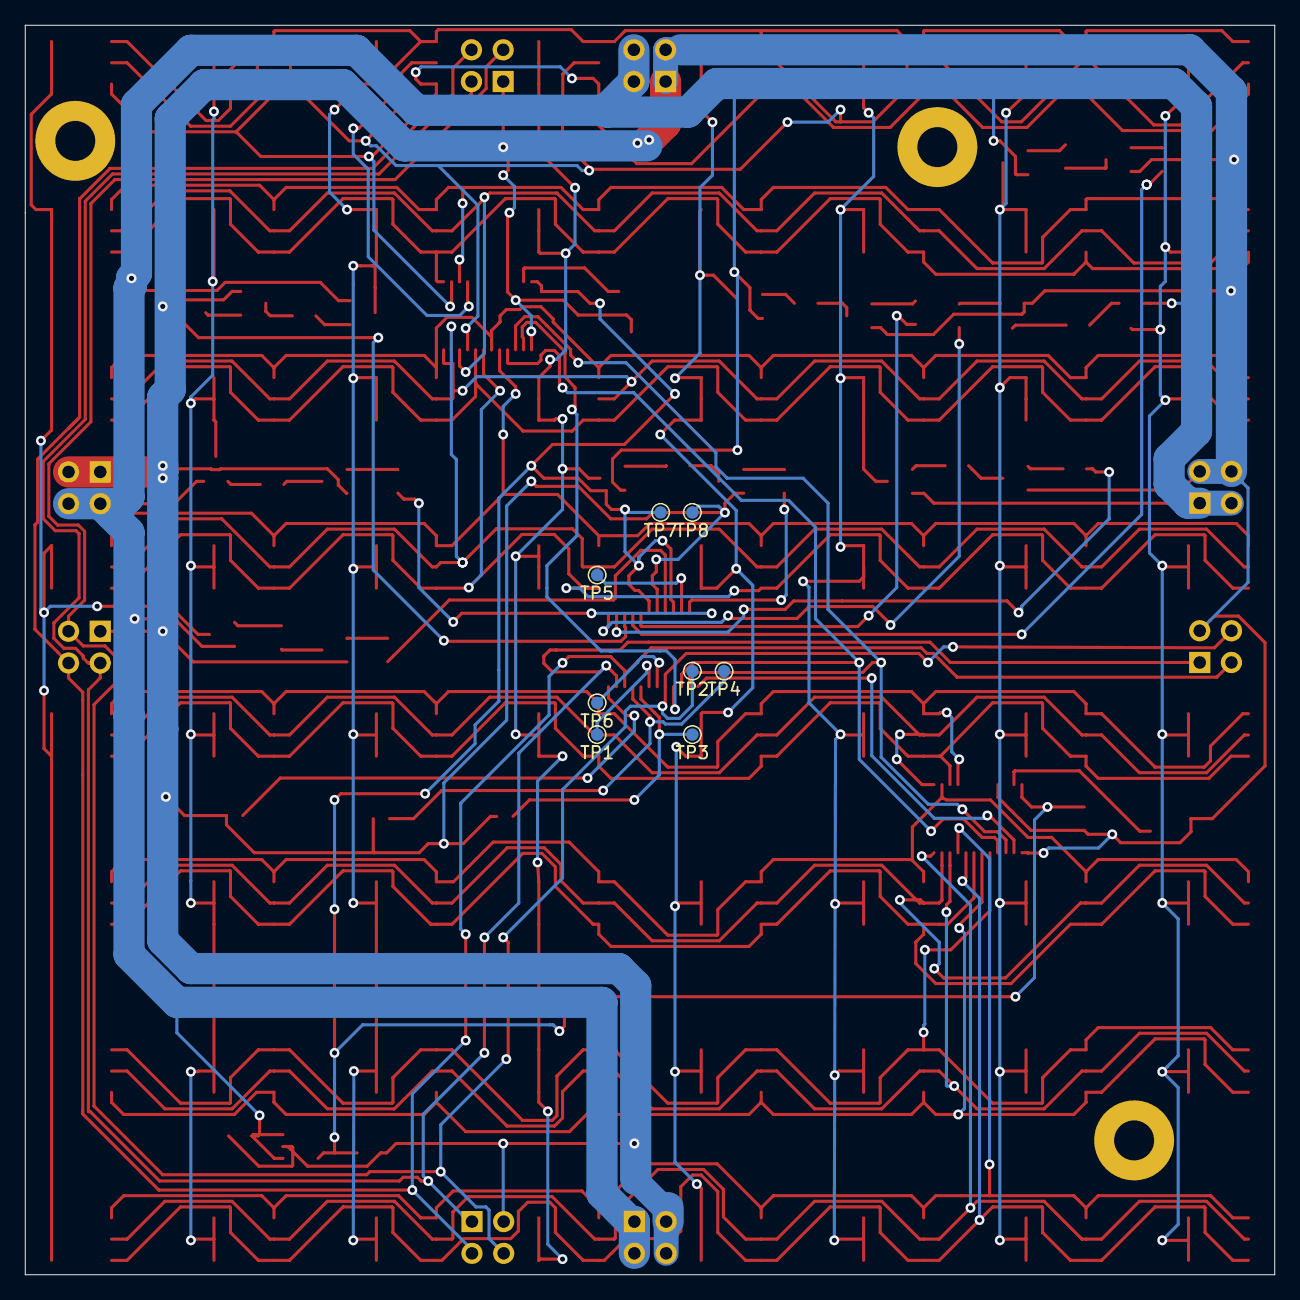
[picture p10: board ledgrid.kicad_pcb from below]

Board: 2 copper layers, 100.0 x 100.0 mm, 126 parts (8 on the bottom side), 82 nets.
