lkolbly/ledgrid/fw/fpga/ipcore_dir/fb_ram_8x5184/simulation/functional/wave_ncsim.sv

 
 
 




window new WaveWindow  -name  "Waves for BMG Example Design"
waveform  using  "Waves for BMG Example Design"

      waveform add -signals /fb_ram_8x5184_tb/status
      waveform add -signals /fb_ram_8x5184_tb/fb_ram_8x5184_synth_inst/bmg_port/CLKA
      waveform add -signals /fb_ram_8x5184_tb/fb_ram_8x5184_synth_inst/bmg_port/ADDRA
      waveform add -signals /fb_ram_8x5184_tb/fb_ram_8x5184_synth_inst/bmg_port/DINA
      waveform add -signals /fb_ram_8x5184_tb/fb_ram_8x5184_synth_inst/bmg_port/WEA
      waveform add -signals /fb_ram_8x5184_tb/fb_ram_8x5184_synth_inst/bmg_port/DOUTA
      waveform add -signals /fb_ram_8x5184_tb/fb_ram_8x5184_synth_inst/bmg_port/CLKB
      waveform add -signals /fb_ram_8x5184_tb/fb_ram_8x5184_synth_inst/bmg_port/ADDRB
      waveform add -signals /fb_ram_8x5184_tb/fb_ram_8x5184_synth_inst/bmg_port/DINB
      waveform add -signals /fb_ram_8x5184_tb/fb_ram_8x5184_synth_inst/bmg_port/WEB
      waveform add -signals /fb_ram_8x5184_tb/fb_ram_8x5184_synth_inst/bmg_port/DOUTB

console submit -using simulator -wait no "run"
