lkolbly/ledgrid/(commit log)

2020-03-08 Add rev B ledgrid
    This is the surface mount refresh of the led grid project.
    [boardconnector.sch, boardconnector_female.sch, led_array.sch, led_column.sch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]
2020-03-08 Add pogoboard for rev B ledgrid
    [ledgrid_programmer-B_Cu.gbr, ledgrid_programmer-B_Mask.gbr, ledgrid_programmer-B_Paste.gbr, ledgrid_programmer-B_SilkS.gbr, ledgrid_programmer-Edge_Cuts.gbr, ledgrid_programmer-F_Cu.gbr, ledgrid_programmer-F_Mask.gbr, ledgrid_programmer-F_Paste.gbr]
2020-03-22 Create pogoboard bracket
    [mount.scad]
